minhnhatluongg/lora_project/img/screenshots/13-login-video.png

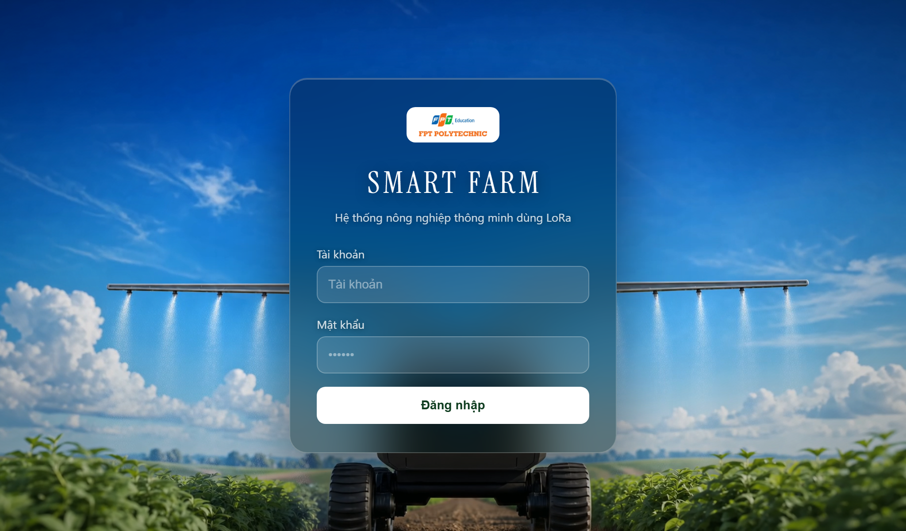
img/screenshots/13-login-video.png
