minhnhatluongg/lora_project/front_require/2.jpg

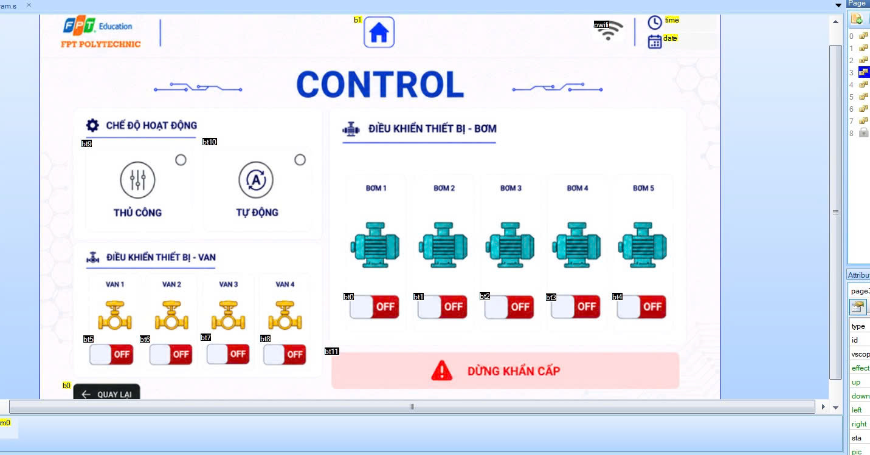
front_require/2.jpg
