minhnhatluongg/lora_project/BAO-CAO-TIEN-DO.docx

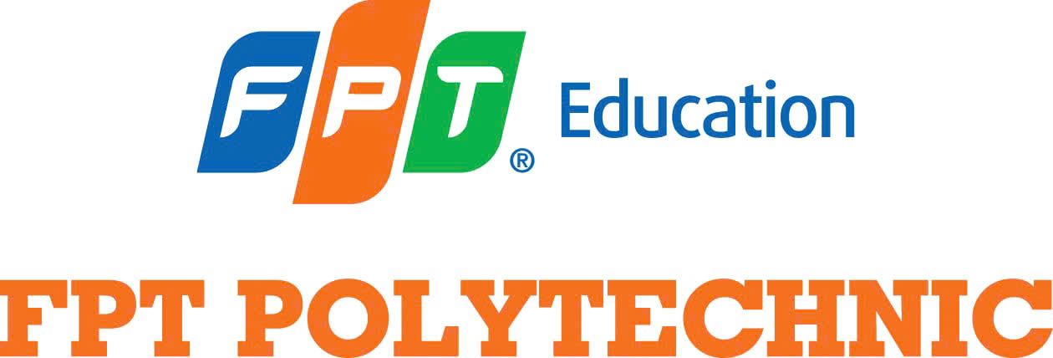
[picture p3: figure]

HỆ THỐNG TƯỚI TIÊU CHÍNH XÁC

ỨNG DỤNG MẠNG LoRa

Báo cáo tiến độ — Luồng điều khiển và kết quả kiểm thử

Kiến trúc ba trạm: STM32F411 · ESP32-S3 · Arduino Nano

Backend Node.js + SQLite · Dashboard React

# 1. Tóm tắt kết quả đợt này

Trọng tâm đợt này là luồng điều khiển (CONTROL) — phần duy nhất còn sai trong khi toàn bộ đường đo và hiển thị số liệu đã chạy đúng. Kết quả gồm ba nhóm: sửa lỗi điều khiển, bổ sung đồng bộ hai chiều, và lần đầu tiên biên dịch kiểm chứng được cả ba board.

## 1.1. Biên dịch kiểm chứng

Trước đợt này chưa từng biên dịch thử; mọi rà soát đều làm bằng mắt. Nay cả ba board đều build sạch:

Board | Bộ nhớ chương trình | RAM | Kết quả
ESP32-S3 | 1.087.601 B (82%) | 48.464 B (14%) | sạch
STM32F411CE | 33.940 B (6%) | 2.148 B (1%) | sạch
Arduino Nano | 12.788 B (41%) | 1.067 B (52%) | sạch

Việc biên dịch phát hiện ba lỗi mà đọc code không thể thấy — trình bày ở mục 4.

# 2. Kiến trúc hệ thống

Ba vi điều khiển, hai chặng LoRa, một cầu WiFi lên máy chủ:

Đầu dò đất RS485 ┐

4 cảm biến siêu âm ├─► STM32F411 ──LoRa──► ESP32-S3 ──WiFi──► Backend :4000

DHT22 + board mưa ┘ (đo, LCD) ▲ (HMI Nextion, └─► Dashboard :5173

│ logic AUTO)

<REQ_DATA> │

ESP32 hỏi thì └──LoRa──► Arduino Nano

STM32 mới trả lời 10 relay

5 bơm · 4 van · 1 đèn báo

Điểm quan trọng về mặt thiết kế: logic tự động nằm trên ESP32, không nằm ở máy chủ. Mất WiFi hay tắt backend thì hệ thống vẫn pha phân và tưới bình thường; chỉ dashboard ngừng cập nhật.

## 2.1. Giao thức giữa các trạm

Bản tin | Chiều | Ý nghĩa
<REQ_DATA> | ESP32 → STM32 | Hỏi số đo. STM32 không tự phát nên không va sóng
<DATA:...> | STM32 → ESP32 | 14 trường: đất, NPK, 4 bồn, không khí, mưa
<ONn> <OFFn> | ESP32 → Nano | Lệnh tay — Nano chỉ nhận khi đang THỦ CÔNG
<AUTOONn> | ESP32 → Nano | Lệnh máy — Nano chỉ nhận khi đang TỰ ĐỘNG
<ACK_> <NACK_> | Nano → ESP32 | Xác nhận hoặc từ chối thật, không ACK giả
<SYNC:> <SYNC_ACK> | hai chiều | Nút cơ mặt tủ, có xác nhận và gửi lại 3 lần
<ESTOP> | ESP32 → Nano | Cắt toàn bộ 10 relay, gửi thẳng không qua hàng đợi

Việc tách lệnh tay và lệnh máy thành hai họ riêng là điểm thiết kế đáng chú ý nhất. Nano áp khóa an toàn đối lập cho hai họ, nên một lệnh tay lọt vào lúc đang chạy tự động sẽ bị từ chối ngay tại board relay — không phụ thuộc phần mềm phía trên có kiểm hay không.

# 3. Luồng điều khiển CONTROL

## 3.1. Ba trạng thái, và vì sao mặc định là "chưa chọn"

Trạng thái | Công tắc bơm/van | Máy tự động
CHƯA CHỌN | khoá toàn bộ | không chạy
THỦ CÔNG | bật/tắt từng cái | không chạy
TỰ ĐỘNG | khoá (phần cứng từ chối) | ESP32 cầm lái

Hệ thống mới cài luôn ở CHƯA CHỌN. Đây là lựa chọn có chủ ý: cả hai chế độ còn lại đều điều khiển bơm thật, nên việc cho máy chạy phải là quyết định có ý thức của người vận hành, không bao giờ là giá trị mặc định. Mô hình này khớp với chính firmware, nơi systemMode khởi tạo bằng -1 nghĩa là "chưa chọn".

## 3.2. Khoá công tắc khi TỰ ĐỘNG là phản ánh sự thật

Web bấm bật Bơm 1

↓

ESP32: systemMode == 1 → từ chối, trả NACK về backend

↓ (giả sử lọt qua)

Nano: isAutoMode == true → "[KHÓA AN TOÀN] từ chối lệnh tay!"

Nếu giao diện vẫn cho bấm thì kết quả là lệnh báo lỗi, không phải thiết bị được bật. Khoá nút là cách nói thật về điều đang xảy ra dưới ruộng, không phải hạn chế do phần mềm tự đặt ra.

## 3.3. Ngưỡng cảnh báo và Luật tự động là hai thứ khác nhau

Đây là chỗ dễ nhầm nhất khi vận hành. Trên màn CÀI ĐẶT có hai mục đều trông giống "ngưỡng":

| Ngưỡng cảnh báo | Luật tự động
Tác dụng | Chỉ hiện cảnh báo | Bật/tắt relay thật
Chạm relay | Không bao giờ | Có
Mặc định | Đang bật | Tắt toàn bộ 9 luật

Phải hội đủ cả ba điều kiện thì relay mới đổi trạng thái: luật được bật và hệ đang ở TỰ ĐỘNG và vừa có gói dữ liệu mới. Thiếu một là không có gì xảy ra — đây là lý do "cài ngưỡng xong mà van không mở".

Khuyến nghị vận hành: để nguyên Luật tự động ở web là tắt. ESP32 có khóa chéo an toàn mà backend hoàn toàn không có.

## 3.4. Khoá chéo an toàn — thứ chỉ ESP32 có

"Khoá chéo" nghĩa là một máy trạng thái bị chặn bởi điều kiện của hệ khác, không chỉ nhìn điều kiện của chính nó. Firmware có bốn lớp:

- Cắt khẩn cấp giữa chừng — bồn nước cạn (trên 80 cm) hoặc mưa to (từ 50%) thì tắt bơm và đóng van ngay giữa chu kỳ tưới, không chờ tưới xong.
- Chưa pha xong thì cấm tưới — máy tưới không khởi động cho tới khi máy pha phân bật cờ isMixingReady. Nước cạn thì không pha được, không pha được thì không tưới được.
- Tuần tự và chờ xác nhận — mở van, chờ 2 giây, rồi mới bật bơm; mất sóng LoRa thì máy trạng thái đứng lại thay vì đi tiếp mù quáng.
- Nano từ chối lệnh tay khi đang tự động — lớp cuối, ngay tại board relay, chặn cả lệnh LoRa lẫn nút cơ trên mặt tủ.

Backend không có lớp nào trong bốn lớp trên: nó không biết bồn cạn, không biết trời mưa, không biết dung dịch đã pha xong chưa. Đó là lý do thực chất của khuyến nghị "chỉ dùng một bộ não".

# 4. Các lỗi đã phát hiện và xử lý

## 4.1. Ba lỗi chỉ lộ ra khi biên dịch thật

Board | Lỗi | Hậu quả nếu để nguyên | Xử lý
Nano | RAM dùng 89%, còn 223 B cho stack | Code dùng String liên tục, heap lớn lên đụng stack, gây reset ngẫu nhiên giữa lúc điều khiển relay | Bọc F() cho 22 chuỗi, còn 52%, dư 981 B
STM32 | Trùng tên biến Serial1 với core | Trình liên kết báo multiple definition, không build được | Đổi tên thành rs485Port
STM32 | Core 3.0.0 đổi HardwareSerial thành lớp trừu tượng | Không build được | Dùng core 2.7.1

## 4.2. Lỗi chặn đường: sai đơn vị EC

Đầu dò RS485 trả về EC theo µS/cm (giá trị cỡ 1500), nhưng ngưỡng trong firmware mặc định 1,0 và 2,0 tức mS/cm, rồi đem so sánh trực tiếp:

if (EC_Value > ecMax) // 1500 > 2.0 → LUÔN ĐÚNG

Hệ quả dây chuyền: máy pha phân kẹt vĩnh viễn ở bước "EC quá cao, châm thêm nước", không bao giờ bật cờ isMixingReady, nên tưới tự động không bao giờ khởi động. Toàn bộ chế độ TỰ ĐỘNG vô hiệu, mà không có thông báo lỗi nào.

Cách sửa giữ nguyên ý định nông học (1,0 và 2,0 mS/cm), chỉ đổi đơn vị cho khớp đầu dò: 1000 và 2000 µS/cm. Thêm hàm quy đổi tại mọi cửa vào để chip đã nạp firmware cũ và người vận hành quen gõ mS/cm đều không bị ảnh hưởng.

Kiểm chứng bằng dải giá trị thật của đầu dò:

EC đo được (µS/cm) | Trước | Sau
400 | pha loãng | châm Đạm + Kali
1200 / 1500 / 1900 | pha loãng | đạt chuẩn
2400 | pha loãng | pha loãng

Trước khi sửa không giá trị nào đạt chuẩn — đúng như suy luận là kẹt vĩnh viễn.

## 4.3. Lỗi "đo đúng mà điều khiển sai"

Triệu chứng người dùng báo: số đo hiển thị chính xác, riêng phần điều khiển sai. Nguyên nhân là hai đường dữ liệu tách biệt — telemetry chạy tốt, còn trạng thái thiết bị thì không.

Mảng pumpState[] mà ESP32 dùng để báo lên dashboard chỉ được cập nhật khi lệnh xuất phát từ web. Ba nguồn còn lại không hề chạm tới nó:

- Bấm nút trên màn Nextion
- Bấm nút cơ dưới tủ điện
- Máy trạng thái AUTO và pha phân tự bật relay — nguồn quan trọng nhất

Kết quả mô phỏng lại đúng bốn đường điều khiển:

| Bơm 1 | Bơm 2 | Bơm 3 | Bơm 4 | Bơm 5 | Van 1
Thực tế dưới ruộng | ON | ON | ON | OFF | ON | ON
Web thấy — trước | ON | ON | ON | ON | OFF | OFF
Web thấy — sau | ON | ON | ON | OFF | ON | ON

Hai kiểu sai cùng lúc: Bơm 4 web báo đang chạy dù Nano đã từ chối lệnh, tức là chưa hề chạy; còn Bơm 5 và Van 1 do máy tự động bật thì web lại báo tắt.

Cách sửa theo nguyên tắc chỉ ghi trạng thái khi Nano đã xác nhận bằng ACK, thay vì ghi lạc quan lúc bấm nút. Một chỗ ghi duy nhất, phủ đủ bốn đường; lệnh bị NACK thì trạng thái giữ nguyên và nút trên màn được kéo về đúng thực tế.

## 4.4. Vùng chết khi bấm nút

Khối xử lý nút bơm/van chỉ có điều kiện systemMode == 0 && !isWaitingAck mà không có nhánh nào khác. Ba tình huống rất hay gặp rơi vào khoảng trống và im lặng tuyệt đối: chưa chọn chế độ, đang ở tự động, và đang chờ xác nhận lệnh trước (cửa sổ tới 6 giây). Người vận hành bấm nút, relay không kêu, màn không báo gì — mà nút thì đã tự đổi màu lúc chạm vào.

Nay mỗi nhánh đều kết thúc bằng một việc thấy được: thông báo trên OLED và đẩy nút về đúng trạng thái thật.

# 5. Nâng cấp luồng điều khiển

## 5.1. Đồng bộ chế độ hai chiều

Chế độ đổi được ở ba nơi: dashboard, màn Nextion, và nút cơ trong tủ điện. Trước đây chỉ nơi đầu tiên đi qua máy chủ, nên web có thể ngồi hiện THỦ CÔNG trong khi ngoài ruộng đã chạy TỰ ĐỘNG cả tiếng.

Bổ sung endpoint POST /api/status/report xác thực bằng khoá thiết bị; ESP32 báo về ở cả ba nguồn. Mỗi lần đổi còn ghi một dòng vào nhật ký cảnh báo, để đọc lại biết vì sao hệ thống bắt đầu hoặc ngừng tưới.

## 5.2. Nút TỰ ĐỘNG nay giao quyền, không bật sẵn thiết bị

Bản trước, bấm TỰ ĐỘNG thì web bật sẵn cả 9 thiết bị rồi mới giao quyền. Bỏ cách làm đó vì hai lẽ: máy trạng thái trên ESP32 ghi đè lại sau vài giây, và bật bơm Đạm/Kali khi chưa pha, chưa khuấy là sai quy trình dinh dưỡng.

Việc quét bật lần lượt toàn dàn được tách thành nút riêng "Kiểm tra toàn dàn", chỉ hiện ở chế độ THỦ CÔNG — đúng lúc nó có ích: nghiệm thu đấu dây tủ điện. Quét giữ hai ràng buộc kỹ thuật: van mở trước bơm (bơm chạy vào ống đóng là chạy chết máy) và cách nhau 2 giây (năm mô-tơ đóng cùng lúc là cú dòng khởi động lớn lên nguồn chung).

## 5.3. Dải tiến trình máy trạng thái

Ở chế độ TỰ ĐỘNG, màn CONTROL trước đây chỉ còn chữ "TỰ ĐỘNG" và chín công tắc xám. Người đứng xem không có cách nào biết hệ thống đang làm gì — mà "vì sao chưa tưới" gần như luôn là câu hỏi đầu tiên.

ESP32 nay gửi kèm bước hiện tại của hai máy trạng thái, dashboard vẽ thành dải tiến trình:

Pha phân: [đổ nước] → [đo EC] → [châm Đạm+Kali] → [khuấy] → đạt chuẩn

│

chưa đạt chuẩn thì KHÓA tưới

↓

Tưới: [chờ đất khô] → [mở van] → [đang tưới] → [đóng van] → [nghỉ thấm]

Dải này vẽ đúng quan hệ nối tiếp giữa hai máy: pha phân phải xong thì tưới mới được phép khởi động. Nhờ vậy màn hình trả lời được câu hỏi vận hành thường gặp nhất — hệ thống đang chờ gì — thay vì chỉ cho biết nó đang bật hay tắt.

# 6. Kiểm thử đã thực hiện

Hạng mục | Cách kiểm | Kết quả
Biên dịch 3 board | Trình biên dịch thật của Arduino | sạch cả ba
Giao thức 3 trạm | Đối chiếu 7 hợp đồng bản tin hai chiều | khớp toàn bộ
Đơn vị EC | Chạy lại quyết định pha phân với dải EC thật | trước kẹt, sau đạt chuẩn
Trạng thái thiết bị | Mô phỏng 4 đường điều khiển kèm trường hợp bị từ chối | dashboard khớp thực tế
Đồng bộ chế độ | Máy chủ chạy thật, giả lập ESP32 báo về | web nhận đúng
Kiểm tra toàn dàn | Đọc thẳng hàng đợi lệnh trong cơ sở dữ liệu | van trước bơm, cách 2 giây
Phân quyền | Gọi API không kèm khoá thiết bị | trả về 401

# 7. Việc còn lại

Việc | Ghi chú
Nạp và chạy thử trên phần cứng thật | Toàn bộ kiểm thử hiện ở mức biên dịch và mô phỏng logic
Sửa nhãn đơn vị EC trên màn Nextion | Đổi mS/cm thành µS/cm, và nới `txt_maxl` lên ít nhất 8 vì số hiển thị dài từ 3 lên 6 ký tự
Chốt giá trị EC theo cây trồng | Hiện đặt 1000–2000 µS/cm, đúng bằng ý định ban đầu của nhóm
Đấu relay cho bơm 2 đến 5 | Phần mềm đã hỗ trợ đủ 5 bơm
