minhnhatluongg/lora_project/HUONG-DAN-TRIEN-KHAI.docx

HỆ THỐNG TƯỚI CHÍNH XÁC LORAWAN

HƯỚNG DẪN TRIỂN KHAI & CẤU HÌNH KHI CHẠY THẬT

“Ứng dụng công nghệ LoRaWAN trong thiết kế hệ thống tưới chính xác

và quản lý dinh dưỡng cho cây ăn quả”

Tài liệu này dùng để làm gì

Trả lời đúng một câu hỏi: cần sửa biến nào, trên máy nào, để tải nguồn về là hệ thống chạy được.

Phần 3 là bảng tra cứu chính. Các phần còn lại là các bước làm và cách xử lý khi hỏng.

# 1. Toàn cảnh hệ thống

Hệ thống gồm 5 thành phần. Ba board phần cứng chạy độc lập với nhau, và một cặp phần mềm chạy trên máy tính.

Đầu dò đất RS485 ─┐

4 × siêu âm ──────┼─► STM32F411 ──LoRa E32 (2 phút/lần)──┐

Không khí + mưa ──┘ │

▼

Nextion HMI ◄──UART── ESP32-S3 MASTER ──WiFi/HTTP──► BACKEND :4000

│ │

│ LoRa E32 ▼

▼ DASHBOARD :5173

Arduino Nano ──► 10 relay

(5 bơm · 4 van · 1 báo AUTO)

Thành phần | Vai trò | Chạy ở đâu
STM32F411 | Đọc cảm biến, hiện LCD, phát LoRa mỗi 2 phút | Tủ ngoài vườn
ESP32-S3 | Master: HMI Nextion, logic AUTO, cầu nối lên web | Tủ điều khiển
Arduino Nano | Đóng cắt 10 relay, nhận nút cơ dưới tủ | Tủ điện
Backend | API + cơ sở dữ liệu SQLite | Máy tính
Dashboard | Giao diện web 5 trang | Trình duyệt

Mất mạng thì sao?

Hệ thống vẫn tưới bình thường. ESP32 có logic AUTO chạy tại chỗ, Nextion và nút cơ dưới tủ vẫn dùng được.

Chỉ có dashboard web là không cập nhật cho tới khi mạng trở lại.

# 2. Chuẩn bị trước khi bắt đầu

Trên máy tính:

- Node.js phiên bản 18 trở lên — kiểm tra bằng node -v
- Arduino IDE, đã cài board ESP32 và 2 thư viện Adafruit GFX + Adafruit SSD1306
- PlatformIO (extension trong VS Code) để nạp STM32

Về mạng:

- Máy chạy backend và ESP32 phải cùng một mạng WiFi
- Ghi lại địa chỉ IP của máy chạy backend — lấy bằng lệnh ipconfig, xem dòng *IPv4 Address*, ví dụ 192.168.1.50
- Mở cổng 4000 trên tường lửa Windows (lệnh ở phần 4)

IP là thứ hay gây lỗi nhất

IP do router cấp có thể đổi sau khi khởi động lại. Nếu hôm nay chạy được mà mai không, hãy kiểm tra IP trước tiên.

Cách chắc chắn: vào router đặt IP tĩnh (DHCP reservation) cho máy chạy backend.

# 3. Bảng biến cấu hình theo từng máy

Đây là phần quan trọng nhất. Cột “Khi nào phải sửa” cho biết biến đó có bắt buộc động vào hay không.

## 3.1 Máy tính chạy backend — file backend/.env

Lần đầu: chép backend/.env.example thành backend/.env rồi sửa file .env.

Biến | Giá trị mặc định | Khi nào phải sửa
PORT | 4000 | Chỉ khi cổng 4000 đã bị chương trình khác chiếm. Sửa thì phải sửa cả ESP32 và vite.config.js.
DEVICE_API_KEY | changeme-esp32-secret | Đã khớp sẵn với ESP32 → KHÔNG cần sửa. Nếu đổi thì phải đổi cả hai phía.
JWT_SECRET | changeme-jwt-secret | Nên đổi thành chuỗi ngẫu nhiên dài trước khi dùng thật.
SEED_ADMIN_PASSWORD | admin123 | Chỉ có tác dụng lần chạy ĐẦU TIÊN khi database còn trống. Đã chạy rồi thì đổi trong giao diện web.
CORS_ORIGIN | http://localhost:5173 | Chỉ khi mở dashboard từ MÁY KHÁC. Xem mục 3.3.
TELEMETRY_RETENTION_DAYS | 90 | Số ngày giữ dữ liệu đo. Đặt 0 để giữ mãi mãi.
MASTER_TIMEOUT_SECONDS | 30 | Bao lâu không có tin thì báo Master OFFLINE. Thường không cần sửa.

## 3.2 ESP32-S3 — file firmware/esp32_master/esp32_master.ino

Khối cấu hình nằm ngay đầu file, có khung dấu # bao quanh cho dễ tìm.

Biến | Giá trị mặc định | Khi nào phải sửa
ssid | "DESKTOP-2GO7JB8 5238" | BẮT BUỘC — tên WiFi của bạn.
password | "78U5%g77kkkkk" | BẮT BUỘC — mật khẩu WiFi.
BACKEND_BASE | "http://192.168.1.50:4000" | BẮT BUỘC — đổi thành IP thật của máy chạy backend. Không dùng localhost.
DEVICE_API_KEY | "changeme-esp32-secret" | Đã khớp sẵn với backend → KHÔNG cần sửa.
ENABLE_WEB_BRIDGE | 1 | Đặt 0 nếu muốn chạy hoàn toàn offline, chỉ dùng Nextion.
CMD_POLL_INTERVAL | 3000 | Bao lâu hỏi lệnh mới từ web (mili giây). Thường không cần sửa.

Vì sao không được dùng localhost trên ESP32

Với ESP32, localhost nghĩa là chính con ESP32, không phải máy tính của bạn. Bắt buộc phải điền IP LAN dạng 192.168.x.x.

## 3.3 Dashboard — khi backend và trình duyệt KHÔNG cùng máy

Đây là chỗ dễ vấp nhất khi nhiều người cùng dùng. Có ba tình huống:

Tình huống | Cần làm gì
Backend + dashboard + trình duyệt cùng 1 máy (cách dùng thông thường) | Không sửa gì cả. Mở http://localhost:5173
Backend + dashboard cùng 1 máy, xem từ điện thoại / máy khác | Không sửa code. Chạy npm run preview (đã bật sẵn --host) rồi vào http://<IP-máy-đó>:5173. Proxy chạy trên máy chủ nên vẫn trỏ đúng, không cần đụng CORS.
Backend ở MÁY A, dashboard chạy ở MÁY B | Sửa frontend/vite.config.js: đổi cả hai dòng http://localhost:4000 thành http://<IP-máy-A>:4000. Sau đó thêm origin của máy B vào CORS_ORIGIN trong backend/.env.

## 3.4 STM32 — file firmware/stm32_sensor_node/src/main.cpp

Biến / Hàm | Mặc định | Khi nào phải sửa
LORA_SEND_INTERVAL | 120000 (2 phút) | Muốn dashboard cập nhật dày hơn thì giảm. Đổi lại tốn pin và chiếm sóng.
readAirSensors() | đang gán số giả | BẮT BUỘC nếu đã lắp cảm biến thật — xem mục 6.
Dist4 = rawD4 + 13.0 | bù 13 cm | Giá trị bù theo sa bàn cũ. Đo lại thực tế rồi chỉnh cho đúng bồn của bạn.

## 3.5 Arduino Nano — file firmware/nano_relay/nano_relay.ino

Bình thường không cần sửa gì. Chỉ đụng vào relayPins[] nếu bạn đấu relay vào chân khác.

Thiết bị trên web | Lệnh LoRa | Chân Nano
pump1 … pump5 (Bơm 1–5) | <ON1> … <ON5> | A1, A0, D2, D3, D4
van1 … van4 (Van 1–4) | <ON6> … <ON9> | D5, D6, D7, D8
(đèn báo đang ở AUTO) | — | D9

# 4. Các bước chạy, theo đúng thứ tự

Làm tuần tự. Mỗi bước có mốc nghiệm thu — chưa đạt thì đừng sang bước sau, vì càng về sau càng khó biết hỏng ở đâu.

## Bước 1 — Chạy backend

cd backend

npm install

copy .env.example .env (Linux/macOS: cp .env.example .env)

npm run seed (tùy chọn: nạp dữ liệu mẫu cho biểu đồ)

npm start

Nghiệm thu: mở http://localhost:4000/api/health phải thấy {"ok":true,...}

## Bước 2 — Chạy dashboard

cd frontend

npm install

npm run build

npm run preview

Nghiệm thu: mở http://localhost:5173, đăng nhập admin / admin123, thấy trang MENU với 6 ô.

## Bước 3 — Mở cổng tường lửa

Chạy PowerShell với quyền Administrator:

New-NetFirewallRule -DisplayName "LoRa backend 4000" -Direction Inbound -LocalPort 4000 -Protocol TCP -Action Allow

## Bước 4 — Nạp Arduino Nano

Mở firmware/nano_relay/nano_relay.ino, nạp. Không cần sửa gì.

Nghiệm thu: Serial Monitor 9600 baud hiện “NANO 2 (SLAVE): SAN SANG NHAN LORA”.

## Bước 5 — Nạp STM32

cd firmware/stm32_sensor_node

pio run (biên dịch thử TRƯỚC khi nạp)

pio run -t upload

pio device monitor

Nghiệm thu: Serial in số đo mỗi giây, LCD hiện dữ liệu, bấm PB5 đổi được 3 trang.

## Bước 6 — Nạp ESP32 (bước quyết định)

Sửa 3 dòng ở mục 3.2 rồi nạp firmware/esp32_master/esp32_master.ino.

Nghiệm thu: Serial Monitor 115200 phải hiện lặp lại:

WiFi connected: 192.168.x.x

[WEB] POST /telemetry -> 201

Mã hiện ra | Nghĩa là gì | Xử lý
201 | Đã ghi dữ liệu thành công | Không phải làm gì
401 | Sai khóa API | So lại DEVICE_API_KEY giữa sketch và backend/.env
-1 | Không nối được tới backend | Sai IP, khác mạng WiFi, hoặc tường lửa chặn
không in gì | Chưa nhận được gói LoRa từ STM32 | Kiểm tra nguồn và ăng-ten module E32 hai đầu

## Bước 7 — Hiệu chuẩn 4 bồn nước

Bắt buộc, nếu bỏ qua thì phần trăm mực nước sẽ sai.

Cảm biến đo khoảng cách từ đầu dò xuống mặt nước — nước càng đầy thì số càng nhỏ.

- Vào SETTINGS → Hiệu chuẩn bồn nước, với mỗi bồn điền 2 số: khoảng cách khi bồn cạn và khi bồn đầy.
- Cột “Đọc hiện tại” hiện ngay kết quả quy đổi để đối chiếu. Nếu bồn đang đầy mà báo 8% thì bạn đã điền ngược hai ô.
- Đổi hiệu chuẩn lúc nào cũng được — phần trăm tính lúc đọc nên dữ liệu lịch sử cũng tự sửa theo.

# 5. Nghiệm thu toàn tuyến

Trên trang DASHBOARD, các thẻ trạng thái phải đúng như sau:

Chỗ cần nhìn | Đúng là thế nào
Thẻ Master | ONLINE — ESP32 có gọi backend trong 30 giây qua
Thẻ Slave | ONLINE — có gói LoRa từ STM32
Thẻ RS485 | “Đọc tốt”
4 thẻ hàng trên | Nhiệt độ, Độ ẩm, pH, EC có số và đổi theo thời gian
Thẻ Kali & Đạm | Có 2 số, đơn vị ppm
3 thẻ không khí / mưa | Có số (nếu đã lắp cảm biến thật — xem mục 6)
Mực nước các bồn | Đúng % so với bồn thật sau khi hiệu chuẩn
Trang CONTROL | Bật/tắt được bơm và van khi ở chế độ THỦ CÔNG

Kiểm tra nút DỪNG KHẨN CẤP (nên làm ít nhất một lần):

- Vào trang CONTROL, bấm DỪNG KHẨN CẤP và xác nhận.
- Toàn bộ 10 relay phải nhả ra, hệ thống tự chuyển về THỦ CÔNG.
- Thử bật một bơm — phải bị từ chối cho tới khi giải trừ.

# 6. Những phần phần cứng chưa hoàn thiện

Phần mềm đã sẵn sàng nhận, nhưng phần cứng còn thiếu. Không ảnh hưởng tới các chức năng khác.

Trên màn hình | Còn thiếu gì
Độ ẩm không khí Nhiệt độ không khí Cảm biến mưa | Hàm readAirSensors() trong main.cpp đang gán số cứng: AirTemp = 32.5; AirHum = 70.0; RainPercent = 15; Thay bằng lệnh đọc DHT22/SHT31 và board cảm biến mưa thật.
Bơm 2 … Bơm 5 | Cần đấu đủ relay và kiểm tra chân trên Nano. Web và LoRa đã điều khiển được sẵn.

## 6b. Ánh xạ 4 bồn — đã chốt theo dây thật

Nhóm phần cứng đã xác nhận thứ tự này. Backend và dashboard đã đặt tên theo đúng đây.

Cảm biến | Chân STM32 | Biến | Bồn
Siêu âm 1 | PB13 (ECHO1) | Dist1 | Bồn Đạm
Siêu âm 2 | PB14 (ECHO2) | Dist2 | Bồn Kali
Siêu âm 3 | PB15 (ECHO3) | Dist3 | Bồn Nước
Siêu âm 4 | PA8 (ECHO4) | Dist4 | Bồn Trộn

Dời đầu dò sang chân khác thì chỉ cần đổi tên trong SETTINGS → Hiệu chuẩn bồn nước, không phải sửa code.

Hệ quả: logic AUTO trong ESP32 đang dùng nhầm hai biến

Với ánh xạ đã chốt ở trên, hai chỗ trong esp32_master.ino tham chiếu ngược nhau:

• if (Dist3 > 50.0) — định đọc mức bồn Trộn để bơm nước vào, nhưng Dist3 là bồn Nước

• isTankEmpty = (Dist4 > 80) — định đọc mức bồn Nước cho khóa an toàn, nhưng Dist4 là bồn Trộn

Hậu quả: bơm châm nước vào bồn trộn chạy theo mực bồn nguồn, và khóa an toàn “hết nước” kích hoạt theo mực bồn trộn.

Cách sửa: đổi chỗ hai biến trong handleAutoMixingLogic() và handleAutoIrrigationLogic() — dùng Dist4 cho bồn trộn, Dist3 cho bồn nước.

Chưa tự sửa vì đây là logic điều khiển bơm thật. Chạy ở chế độ THỦ CÔNG thì không ảnh hưởng gì.

# 7. Lỗi thường gặp

Hiện tượng | Nguyên nhân thường gặp
Dashboard trống, Master OFFLINE | ESP32 chưa nối được WiFi, hoặc sai IP backend, hoặc tường lửa chặn cổng 4000.
Serial ESP32 in -> 401 | DEVICE_API_KEY trong sketch khác trong backend/.env.
Bấm nút trên web không có gì xảy ra | Hệ thống đang ở TỰ ĐỘNG. Nano khóa mọi lệnh tay. Chuyển sang THỦ CÔNG.
Web hiện bơm ON nhưng thực tế không chạy | Xem trang Cảnh báo. Nếu có “lệnh không được xác nhận” thì đường LoRa xuống Nano đang đứt.
Thẻ RS485 báo “Không phản hồi” | Nguồn đầu dò (thường 12V), thử đảo 2 dây A/B, kiểm tra địa chỉ Modbus phải là 0x02.
Thẻ RS485 báo “Sai CRC” | Nhiễu: gắn điện trở 120Ω hai đầu bus, dùng dây đôi xoắn, tách xa dây động lực bơm.
Một bồn báo “Mất tín hiệu” | Mặt nước xa quá 4m, cảm biến lắp nghiêng, hoặc 4 cảm biến nhiễu chéo nhau (dùng chung chân Trig).
Số liệu 2 phút mới đổi một lần | Đúng như thiết kế. Bấm nút PB7 trên STM32 để ép gửi ngay.
Hôm qua chạy, hôm nay không | Kiểm tra IP máy backend trước tiên — router có thể đã cấp IP khác.

Về bảo mật

Khóa changeme-esp32-secret nằm công khai trong mã nguồn. Chấp nhận được với mạng LAN nội bộ phòng lab.

Đổi cả hai phía (backend/.env và sketch ESP32) nếu hệ thống được mở ra Internet, và đổi luôn JWT_SECRET cùng mật khẩu admin.

Nút DỪNG KHẨN CẤP trên web là chốt chặn phần mềm. Nó không thay thế nút dừng khẩn cấp cứng nối trực tiếp vào nguồn relay — hệ bơm nước ngoài đồng vẫn nên có một nút cơ khí độc lập.

Chi tiết kỹ thuật xem thêm: README.md, HUONG-DAN-CHAY-THAT.md và firmware/README.md trong mã nguồn.
