minhnhatluongg/lora_project/front_require/1.jpg

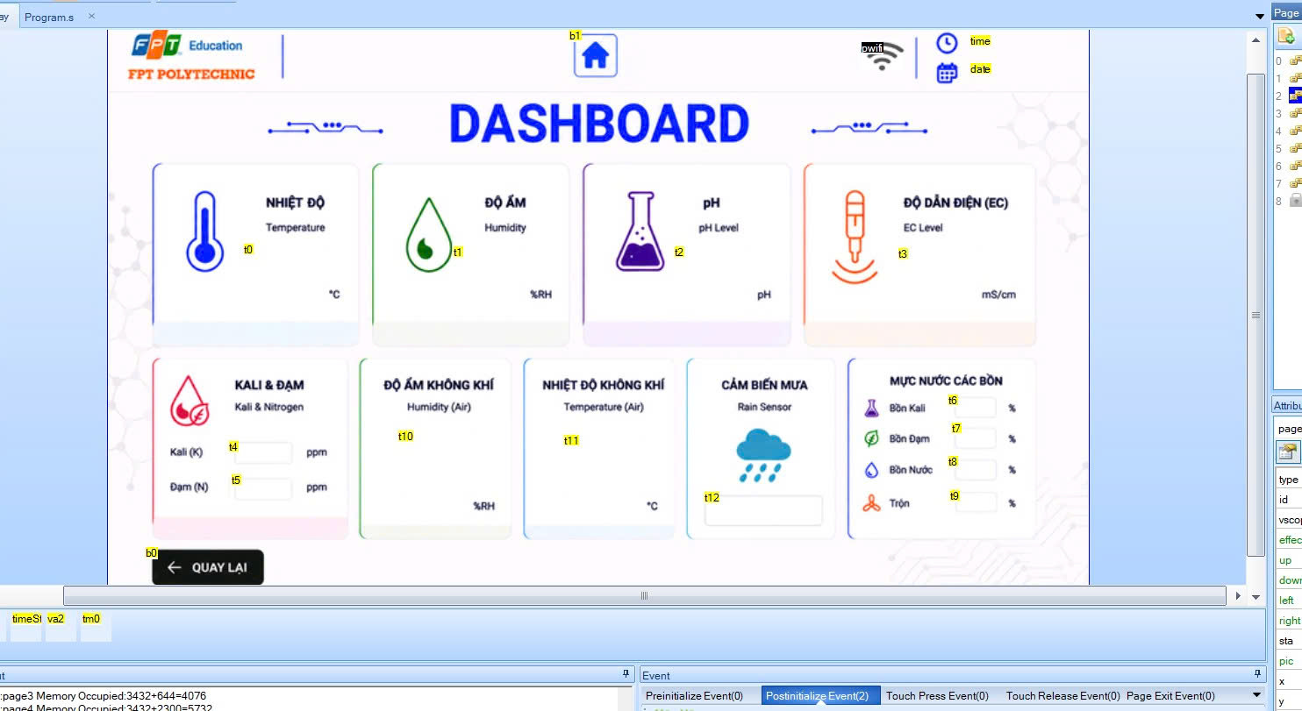
front_require/1.jpg
