minhnhatluongg/lora_project/front_require/3.jpg

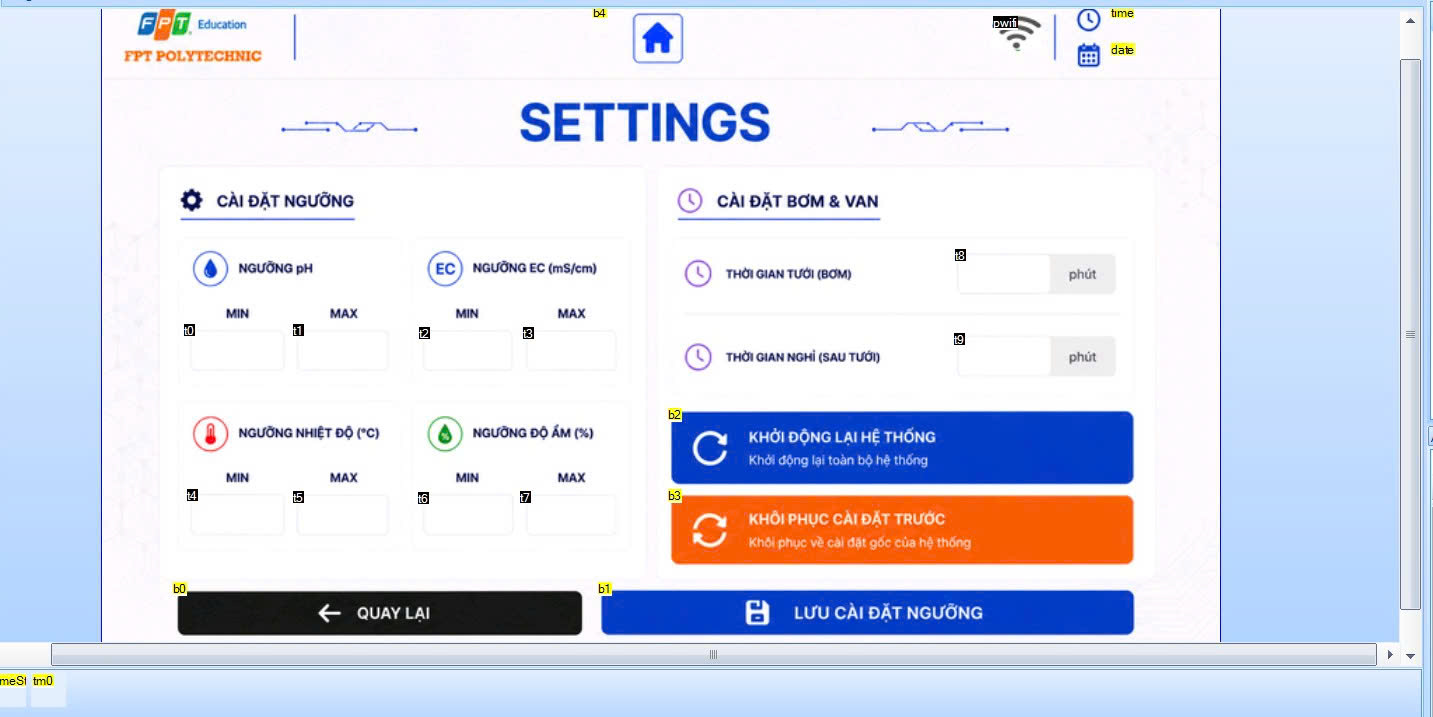
front_require/3.jpg
