minhnhatluongg/lora_project/front_require/4.jpg

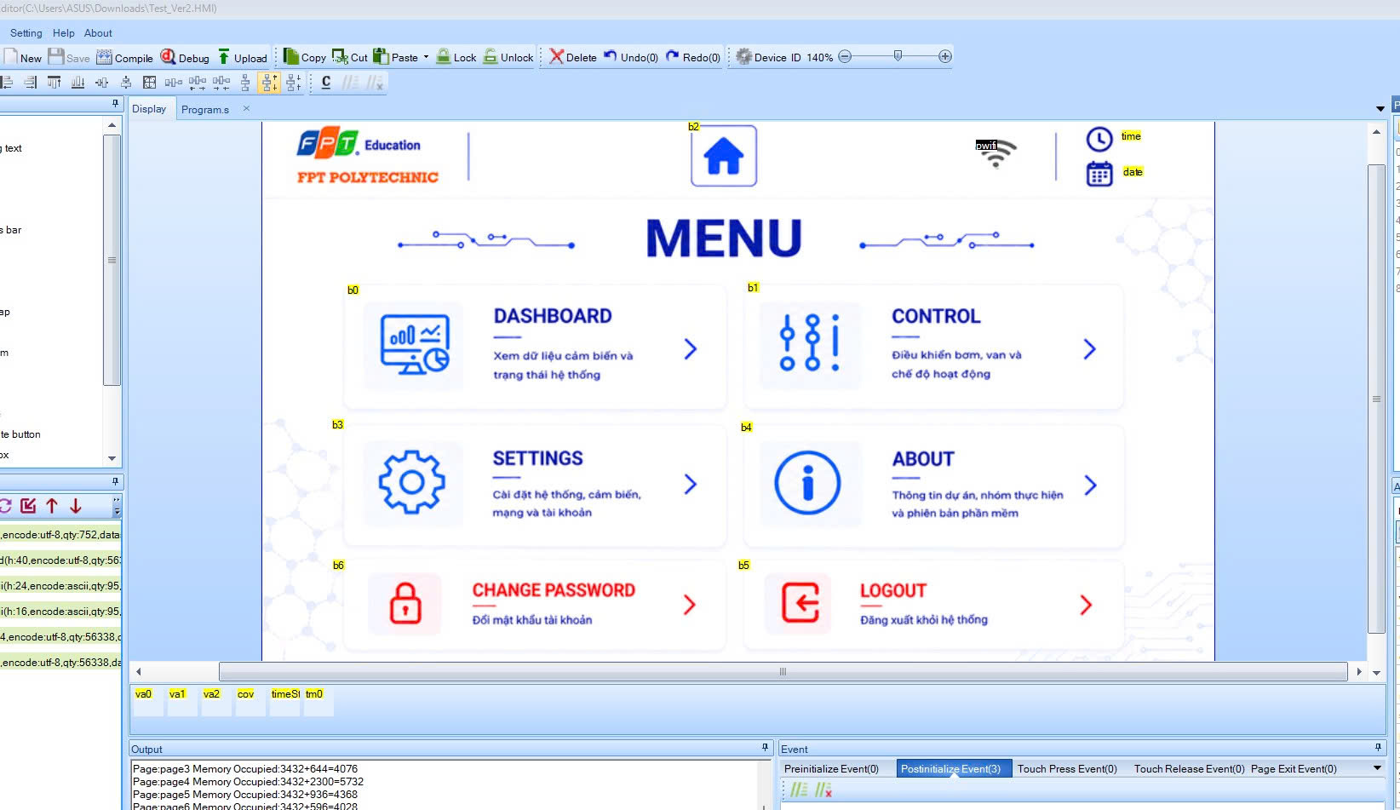
front_require/4.jpg
