minhnhatluongg/lora_project/front_require/5.jpg

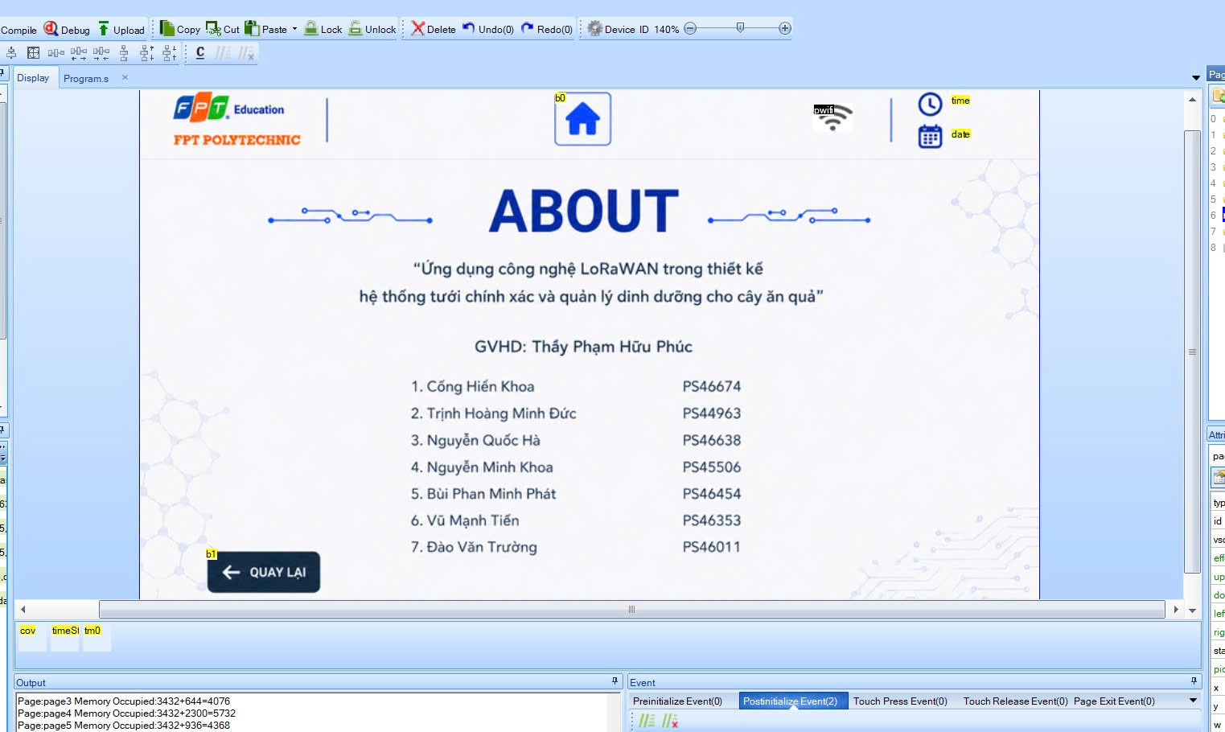
front_require/5.jpg
