minhnhatluongg/lora_project/img/screenshots/01-menu.png

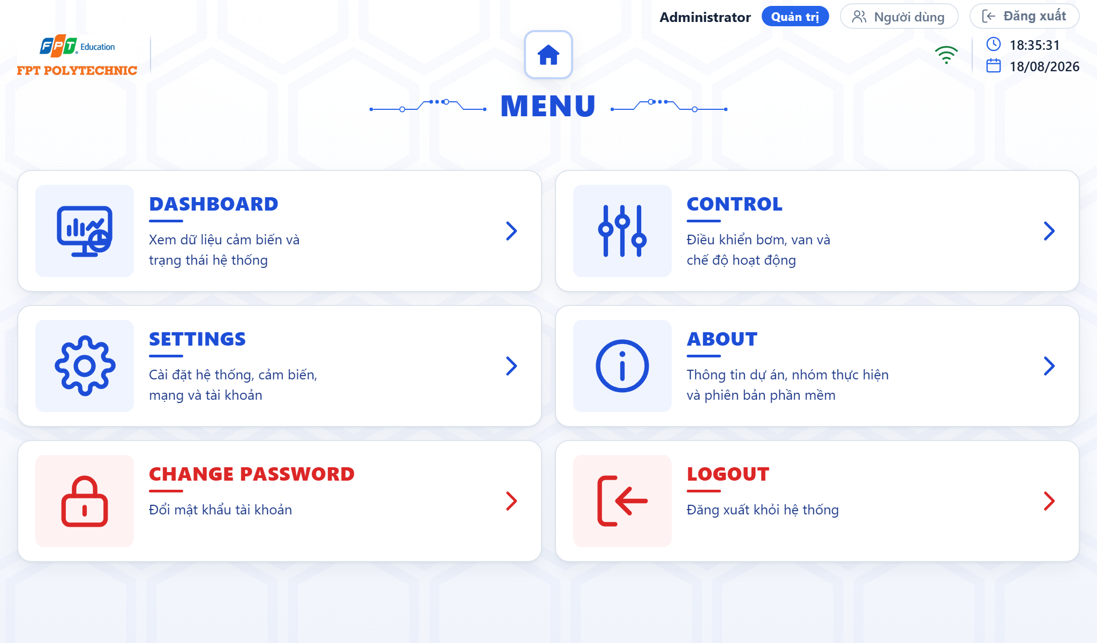
img/screenshots/01-menu.png
