minhnhatluongg/lora_project/img/screenshots/02-control-thu-cong.png

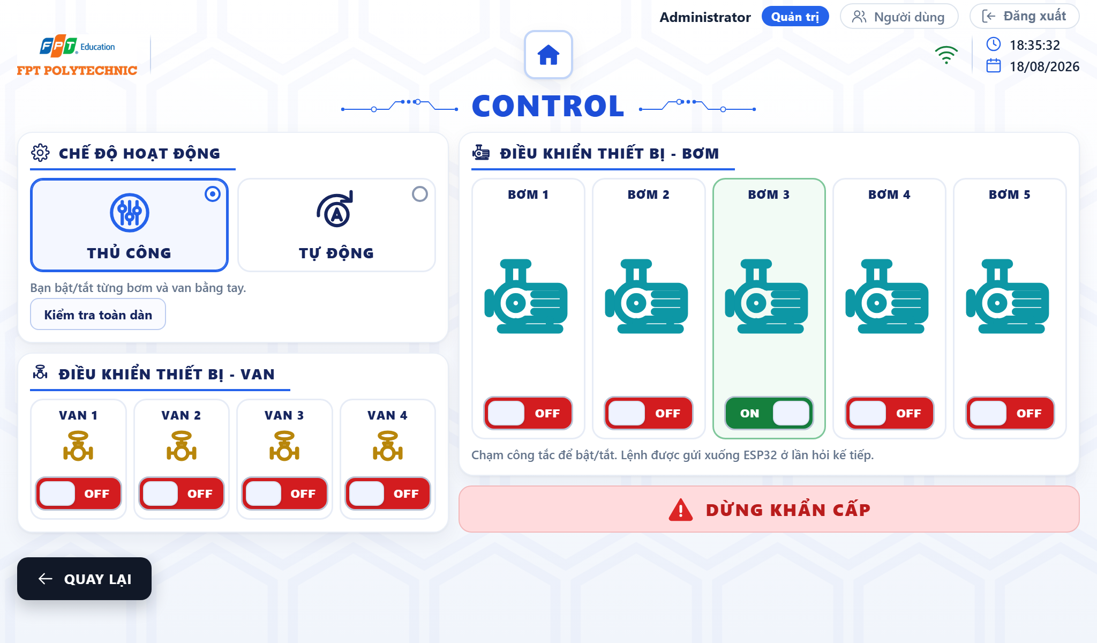
img/screenshots/02-control-thu-cong.png
