minhnhatluongg/lora_project/img/screenshots/03-settings-toggle.png

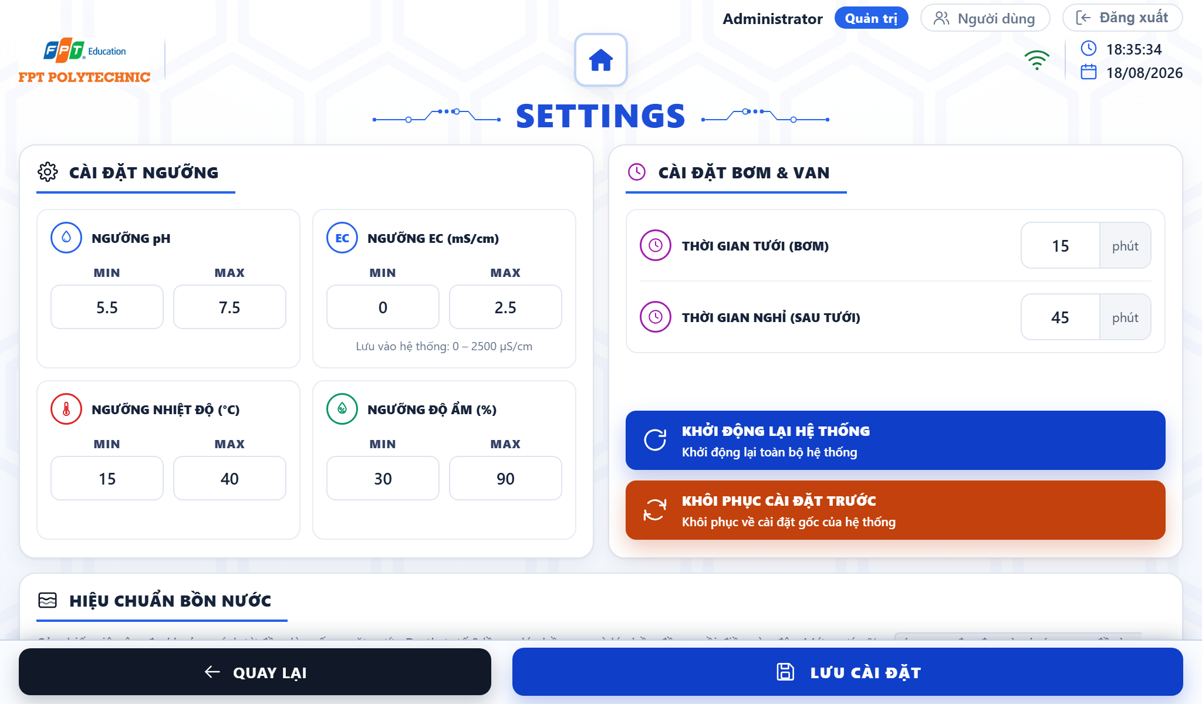
img/screenshots/03-settings-toggle.png
