minhnhatluongg/lora_project/img/screenshots/04-settings-toggle-luat.png

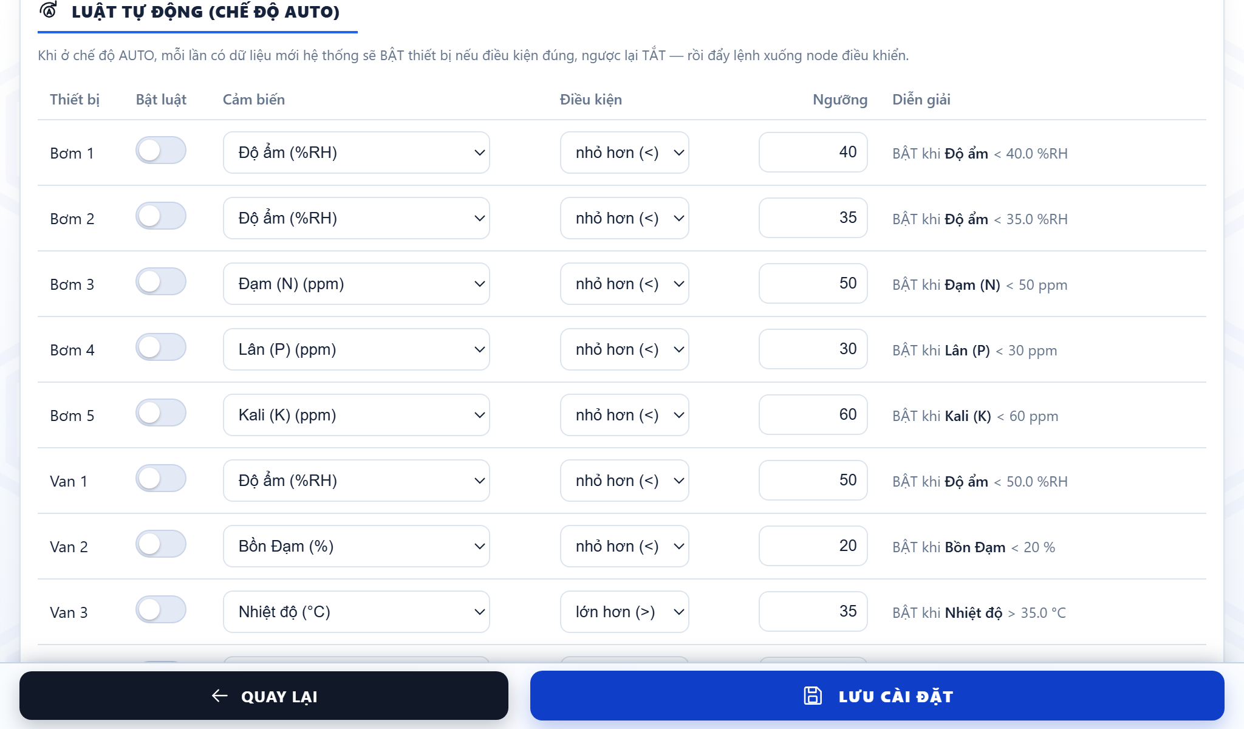
img/screenshots/04-settings-toggle-luat.png
