minhnhatluongg/lora_project/img/screenshots/05-control-quet-dang-chay.png

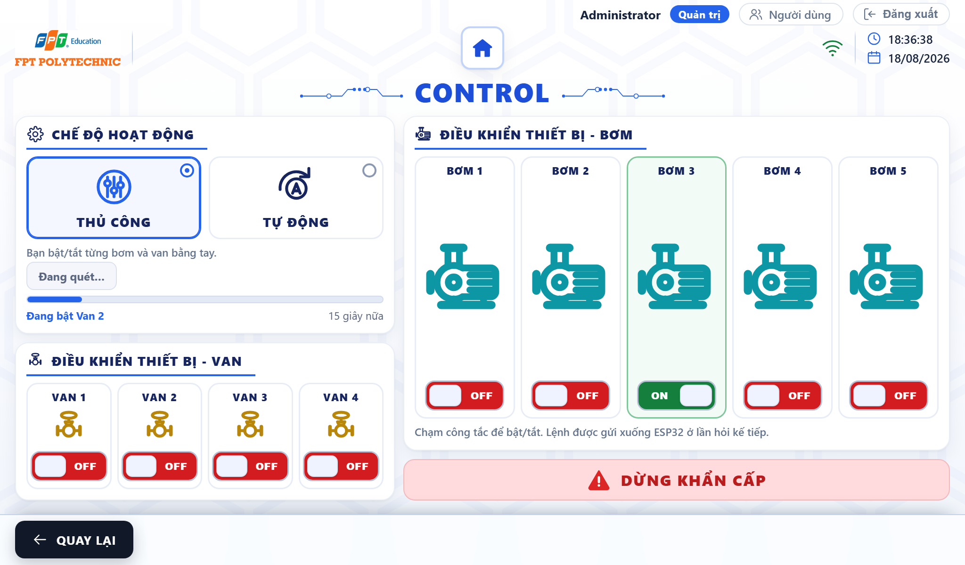
img/screenshots/05-control-quet-dang-chay.png
