minhnhatluongg/lora_project/img/screenshots/07-control-quet-xong.png

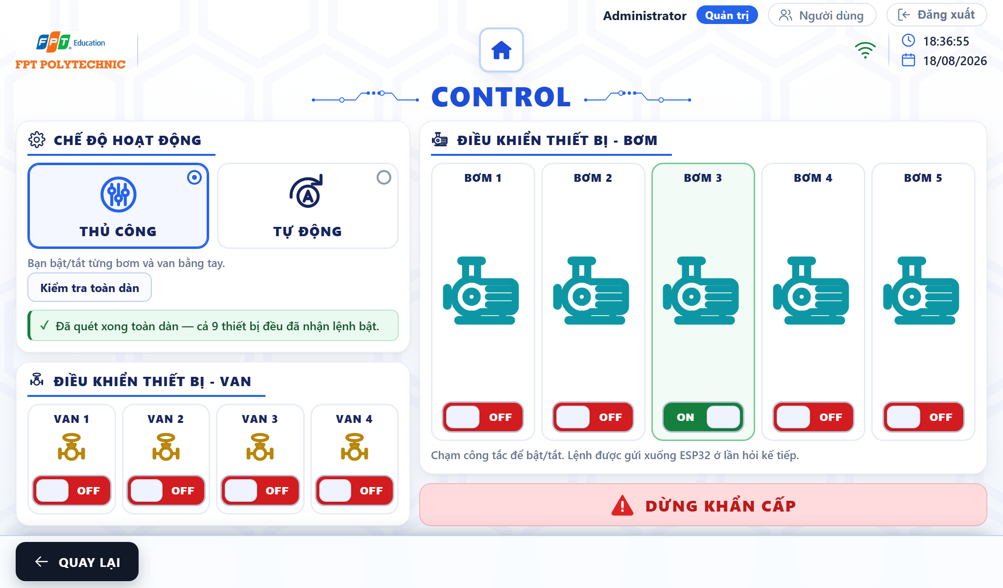
img/screenshots/07-control-quet-xong.png
