minhnhatluongg/lora_project/img/screenshots/08-control-tu-dong-dang-pha.png

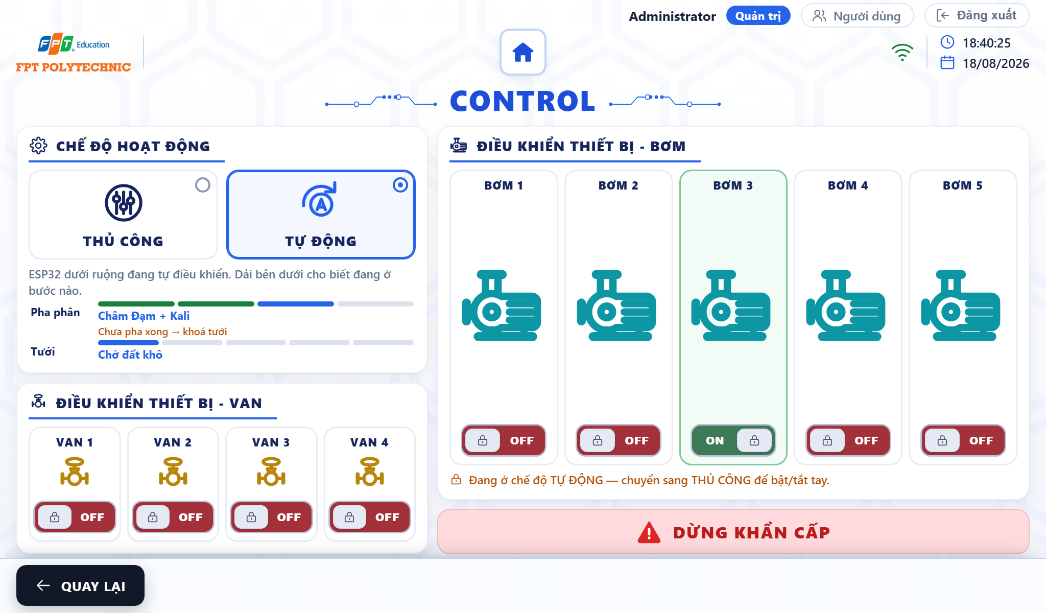
img/screenshots/08-control-tu-dong-dang-pha.png
