minhnhatluongg/lora_project/img/screenshots/09-control-tu-dong-dang-tuoi.png

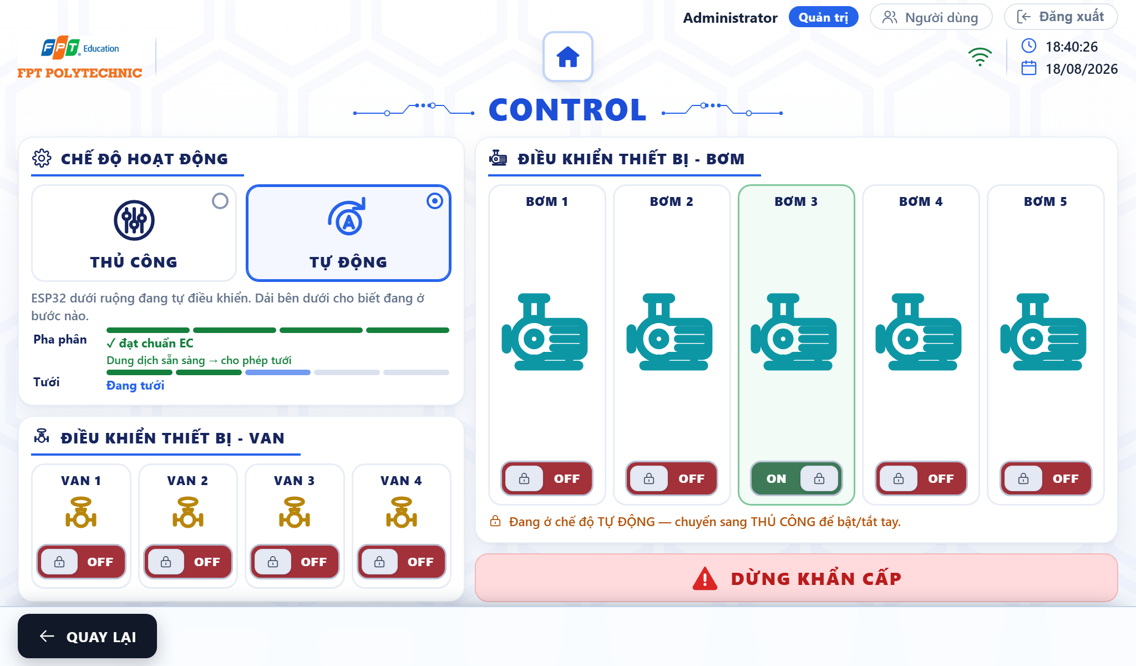
img/screenshots/09-control-tu-dong-dang-tuoi.png
