minhnhatluongg/lora_project/img/screenshots/10-dashboard-nut-lay-du-lieu.png

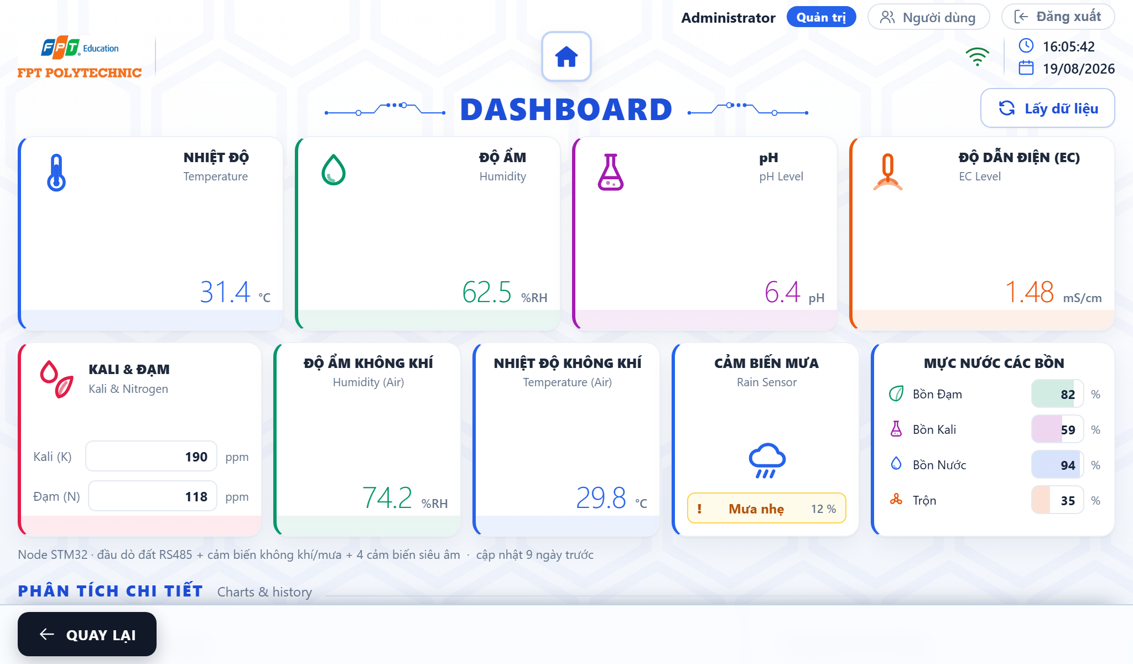
img/screenshots/10-dashboard-nut-lay-du-lieu.png
