minhnhatluongg/lora_project/Bug_Log_Smart_Farm.xlsx

Mã lỗi | Phân hệ (Module) | Mô tả hiện tượng (Bug Description) | Nguyên nhân kỹ thuật (Root Cause) | Trạng thái & Hướng xử lý (Action Plan)
BUG-01 | Đồng bộ Cấu hình (HMI -> Web) | Đổi thông số ngưỡng trên màn hình HMI, ấn Lưu nhưng giao diện Web không hiển thị số mới. | ĐÚNG (đã kiểm chứng). Chính xác hơn: sự kiện này chưa hề tồn tại ở CẢ HAI phía, không phải Frontend thiếu lắng nghe. Backend setConfig() chỉ ghi SQLite rồi return, và danh sách EVENTS trong realtime.js không có mục nào cho cấu hình — nên không có gì để Frontend nghe. | ĐÃ SỬA. Thêm sự kiện 'config-changed'; setConfig() phát chuông ở mọi đường ghi, kể cả POST /api/config/thresholds do ESP32 gửi lên từ màn hình HMI. Chuông đi RỖNG (không kèm nội dung) vì socket chưa xác thực — client nghe được thì tự gọi lại GET /api/config bằng token của mình. Đang gõ dở thì KHÔNG tự đè: hiện dải cảnh báo với hai lựa chọn 'Nạp số mới' / 'Giữ nguyên'. Đo trên trình duyệt thật: đổi ở HMI thì pH min 5.5 -> 6.9 và thời gian tưới 15 -> 31 phút trong ~2 giây, không cần F5; ô đang gõ 7.7 được giữ nguyên; không tràn ngang ở 1440px lẫn 390px.
BUG-02 | Đồng bộ Cấu hình (Web -> HMI) | Nhập thông số ngưỡng mới trên Web, ấn Lưu nhưng màn hình HMI và ESP32 vẫn giữ số cũ. | Route PUT /api/config của Backend Node.js chỉ ghi cấu hình vào SQLite, thiếu logic gọi hàm enqueueCommand để tạo lệnh cho ESP32 kéo về cập nhật. | ĐÃ SỬA (commit cf9bad3). Một điều chỉnh so với mô tả: gửi xuống bằng chuỗi 'SAVE=' mười trường chứ KHÔNG dùng JSON — ESP32 đọc phản hồi vào bộ đệm DynamicJsonDocument 1024 byte, mười khoá JSON chiếm quá nửa. Firmware xử lý được cả hai dạng. Quan trọng: EC phải CHIA 1000 khi gửi xuống (web lưu µS/cm, sketch giữ mS/cm) — gửi thẳng là đặt sai ngưỡng một nghìn lần. Chỉ xếp lệnh khi một trong mười giá trị thật sự đổi, nên sửa hiệu chuẩn bồn nước không đánh thức tủ điện. Đo: 1200 µS/cm đi trọn vòng web → ESP32 → STM32 → web không lệch; bấm Lưu 3 lần liên tiếp gộp còn 1 lệnh mang giá trị cuối.
BUG-03 | Điều khiển (Safety Logic) | Nút Dừng khẩn cấp (E-Stop) trên Web không cắt điện rơ-le ở tủ điện ngay lập tức. | Hàm setEmergencyStop ở Backend chỉ đổi trạng thái mềm sang MANUAL và tắt lẻ tẻ từng van, không tạo mã lệnh ESTOP đích danh để ESP32 kích hoạt ngắt phần cứng. | ĐÃ SỬA (commit cf9bad3), nhưng KHÁC đề xuất ở hai điểm quan trọng. (1) Dùng device_id 'estop', KHÔNG dùng 'system'. enqueueCommand xoá mọi lệnh còn sống cùng device_id, mà /api/system/restart và fetch-now đều đã dùng 'system' — đã đo: lệnh RESTART bị nút 'Lấy dữ liệu ngay' xoá mất. Đặt ESTOP vào đó thì một nút làm mới dữ liệu có thể huỷ lặng lẽ lệnh dừng khẩn cấp. (2) Phải đổi cả THỨ TỰ, không chỉ thêm lệnh. Nguyên nhân sâu hơn mô tả: firmware TỪ CHỐI mọi lệnh bơm/van từ web khi tủ đang ở TỰ ĐỘNG (if systemMode != 0 -> ack false). Thứ tự cũ xếp 9 lệnh TẮT rồi mới tới mode=MANUAL, nên đúng lúc cần nhất thì cả 9 lệnh bị đá về. Nay: estop → mode → các lệnh TẮT (giữ làm lớp đỡ). Cả dàn tắt trong MỘT nhịp hỏi ~3 giây. LƯU Ý TRIỂN KHAI: nạp firmware mới trước hoặc cùng lúc. Bản trước 3d04be2 nhận estop thì đặt webCommandId mà không ack, và clearCommandQueue() không đụng isWaitingAck nên không gì gỡ ra — cú dừng vẫn nổ đúng, nhưng ESP32 đó sẽ không nhận thêm lệnh web nào cho tới khi khởi động lại.
BUG-04 | Giao tiếp (Độ trễ) | Bật/tắt rơ-le Bơm và Van từ Web bị trễ (delay) khoảng 2 giây thiết bị mới phản hồi. | Ý 1 ĐÚNG, Ý 2 SAI. 1. ĐÚNG: WEB_POLL_INTERVAL = 3000ms (esp32_master.ino dòng 58). Đây là toàn bộ nguyên nhân — trung bình chờ 1,5 giây, tệ nhất 3 giây, cộng một lượt LoRa. 2. SAI: PANEL_STAGGER_SECONDS KHÔNG liên quan tới việc bật một rơ-le. Nó chỉ dùng trong enqueueAllDevices (Kiểm tra toàn dàn và Bỏ chọn chế độ). Đã đo: POST /api/devices/pump1/command tạo lệnh có run_after = null, lấy được ngay lập tức — backend không thêm một mili-giây trễ nào. | ĐÃ SỬA (không còn để By Design nữa). Độ trễ đo được giảm từ ~1830 ms xuống ~32 ms. Cách làm: máy chủ GIỮ yêu cầu /api/commands/pending lại (?wait=) thay vì trả mảng rỗng ngay, và trả về đúng lúc có lệnh mới vào hàng đợi. KHÔNG rút ngắn chu kỳ hỏi — đó là cách sai: firmware đặt setReuse(false) nên mỗi lượt hỏi mở một kết nối TLS mới, hỏi dày gấp ba là bắt tay TLS gấp ba, mà tác vụ mạng trên ESP32 chạy TUẦN TỰ nên nó sẽ giành mất chỗ của việc đẩy số đo lên. Mức giữ co giãn theo hạn đẩy số đo kế tiếp, nên nhịp telemetry KHÔNG bị trễ một mili giây nào (đo: 3013 ms trước và sau) và số lượt hỏi lúc rảnh giữ nguyên (0,332 → 0,330 lượt/giây). Mỗi lệnh người dùng bấm tốn thêm đúng một lượt hỏi. Máy chủ cũng tự co mức giữ khi có lệnh hẹn giờ sắp tới hạn, nên nút 'Kiểm tra toàn dàn' vẫn giãn đúng 2 giây một bậc (đo: 9 lệnh, các bậc 2.0 giây). Bỏ trống ?wait thì hành xử y như cũ — firmware bản cũ đang chạy ngoài đồng không bị ảnh hưởng (đo: trả rỗng trong 2 ms). Cơ chế giãn 2 giây chống sụt áp vẫn còn nguyên và VẪN nên khoe với hội đồng — chỉ là khoe ở nút 'Kiểm tra toàn dàn', đúng chỗ nó thật sự chạy.
