minhnhatluongg/lora_project/firmware/esp32_master/esp32_master.ino

#include <HardwareSerial.h>
#include <Wire.h>
#include <Adafruit_GFX.h>
#include <Adafruit_SSD1306.h>
#include <WiFi.h>
#include "time.h"
#include <Preferences.h>
#include <HTTPClient.h>
#include <WiFiClientSecure.h>
#include <ArduinoJson.h>

Preferences preferences;
HardwareSerial loraSerial(1); 
HardwareSerial nextion(2);

#define SCREEN_WIDTH 128
#define SCREEN_HEIGHT 32
#define OLED_RESET -1
#define SCREEN_ADDRESS 0x3C
#define I2C_SDA 9
#define I2C_SCL 10
Adafruit_SSD1306 display(SCREEN_WIDTH, SCREEN_HEIGHT, &Wire, OLED_RESET);

#define LORA_M0 5
#define LORA_M1 6
#define LORA_AUX 8
#define LORA_RX_PIN 18
#define LORA_TX_PIN 17

#define NEXTION_RX 12
#define NEXTION_TX 11

const char* ssid = "DESKTOP-2GO7JB8 5238";
const char* password = "78U5%g77kkkkk";
const char* ntpServer = "time.google.com";
const long gmtOffset_sec = 7 * 3600; 
const int daylightOffset_sec = 0;
const char* BACKEND_BASE = "https://fpoly-smartfarm.id.vn";
const char* DEVICE_API_KEY = "changeme-esp32-secret";
const uint16_t HTTP_CONNECT_TIMEOUT_MS = 1500; 
const uint16_t HTTP_TIMEOUT_MS = 2500;

TaskHandle_t webTaskHandle = NULL;
SemaphoreHandle_t systemMutex = NULL; 
SemaphoreHandle_t queueMutex = NULL;

volatile bool telemetryPending = false, settingsPending = false, deviceStatePending = false, wifiUIUpdatePending = false;
// Co bao cho webTask day tien trinh AUTO/TRON len web. Dat = true o MOI lan
// chuyen trang thai cua hai may trang thai ben duoi; thieu no thi dai tien trinh
// tren trang CONTROL khong bao gio co du lieu.
volatile bool statusReportPending = false;
bool lastWiFiState = false; 
int webCommandId = -1, webAckId = -1;
volatile bool webAckPending = false; 
bool webAckSuccess = false;

unsigned long lastWebPoll = 0, lastTelemetryPost = 0, lastStatePush = 0;
// WEB_POLL_INTERVAL khong con la "do tre cua mot lenh" nua. May chu GIU yeu cau
// lai toi WEB_POLL_HOLD_MS (xem ?wait= trong routes/commands.js) roi tra ve
// NGAY khi co lenh, nen do tre gio xap xi thoi gian truyen chu khong phai chu
// ky hoi. Con so nay chi la khoang nghi giua hai lan mo lai duong cho.
//
// Truoc day de 3000: bam BAT roi cho trung binh 1,5 giay, xau nhat 3 giay.
// Rut ngan chu ky la cach sai — moi luot hoi mo mot ket noi TLS moi
// (setReuse false), ma tac vu mang nay chay TUAN TU nen hoi day gap ba se
// giau mat cho cua viec day so do len.
const unsigned long WEB_POLL_INTERVAL = 150UL, TELEMETRY_INTERVAL = 3000UL, STATE_PUSH_INTERVAL = 5000UL;

// Muc giu KHONG co dinh — no an theo cho trong con lai truoc lan day so do ke
// tiep. Ly do: tac vu mang nay chay TUAN TU, dang giu yeu cau lenh thi khong
// day telemetry duoc. Giu cung 2 giay thi so do bi tre toi 2 giay, va vi moi
// chu ky ngan hon 3 giay nen so luot hoi con TANG (do duoc: +64%) — moi luot
// lai la mot bat tay TLS vi setReuse dang tat.
//
// Giu dung toi luc telemetry toi han thi ca hai deu duoc: so luot hoi giu
// nguyen nhu cu (~1 luot moi 3 giay), so do khong tre mot mili giay nao, ma do
// tre cua lenh tut tu ~1,5 giay xuong con bang thoi gian truyen.
const unsigned long WEB_POLL_HOLD_MIN_MS = 250UL;
const unsigned long WEB_POLL_HOLD_MAX_MS = 3000UL;

String systemPassword; 
unsigned long lastUpdate = 0; 
int systemMode = -1;  
bool pumpState[5] = {false, false, false, false, false}; 
bool valveState[4] = {false, false, false, false};

unsigned long lastLoraRxTime = 0, lastSensorPollTime = 0;
const unsigned long SENSOR_POLL_INTERVAL = 2000UL, LORA_ONLINE_TIMEOUT = 180000UL;
const unsigned long AUTO_POLL_INTERVAL = 300000UL; 

float Temperature = 0.0, Humidity = 0.0, pH_Value = 0.0, EC_Value = 0.0;
uint16_t Nitrogen = 0, Phosphorus = 0, Potassium = 0;
float Dist1 = 0.0, Dist2 = 0.0, Dist3 = 0.0, Dist4 = 0.0;
int RainPercent = 0; 
float AirTemp = 0.0, AirHum = 0.0;
float phMin, phMax, ecMin, ecMax, tempMin, tempMax, humMin, humMax; 
int timeBom, timeNghi;
const float WATER_EMPTY_DIST = 80.0; 
const int RAIN_MAX_PERCENT = 50;

const int QUEUE_SIZE = 15; 
String cmdQueue[QUEUE_SIZE]; 
int queueHead = 0, queueTail = 0;

unsigned long lastSendTime = 0;
const unsigned long TIMEOUT_MS = 2000UL;      
const unsigned long INTER_CMD_DELAY = 100UL;  
const int MAX_RETRIES = 2;                   
int retryCount = 0; 
String currentCommand = ""; 
bool isWaitingAck = false;

const char* EMERGENCY_COMMAND = "<B:ESTOP>";

enum AutoState { AUTO_IDLE, AUTO_OPEN_VALVE, AUTO_WAIT_VALVE_ON, AUTO_WAIT_PUMP_ON, AUTO_IRRIGATING, AUTO_WAIT_PUMP_OFF, AUTO_WAIT_VALVE_OFF, AUTO_WAIT_RESTING_CMD, AUTO_RESTING };
AutoState autoState = AUTO_IDLE; 
unsigned long autoStateTimer = 0;
int currentValveIdx = 0; 

enum MixState { MIX_IDLE, MIX_START_PUMP3, MIX_PUMPING_WATER, MIX_STOP_PUMP3, MIX_WAIT_STABLE, MIX_START_DOSING, MIX_DOSING_NUTRIENT, MIX_STOP_DOSING };
MixState mixState = MIX_IDLE; 
unsigned long mixStateTimer = 0; 
bool isMixingReady = false;

int currentPage = 0; 

// Mo phong muc nuoc bon tron, danh cho luc DEMO tren ban khong co cam bien.
//
// Dat = true thi Dist4 bi GHI DE bang so mo phong moi giay, nen man hinh khong
// con hien so do that nua. Mac dinh = false: doc that tu cam bien sieu am qua
// LoRa. Doi mot dong nay la du de chuyen qua lai.
const bool SIMULATE_TANK_LEVEL = false;
float simDist4 = 80.0; 

String getValue(String data, char separator, int index) {
  int found = 0;
  int startIndex = 0;
  int endIndex = -1;
  
  for (int i = 0; i < data.length(); i++) {
    if (data.charAt(i) == separator) {
      endIndex = i;
      if (found == index) {
        return data.substring(startIndex, endIndex);
      }
      startIndex = i + 1;
      found++;
    }
  }
  if (found == index) {
    return data.substring(startIndex);
  }
  return "";
}

void sendNextionCmd(const String& cmd) { nextion.print(cmd); nextion.write(0xFF); nextion.write(0xFF); nextion.write(0xFF); }
void sendText(const String& obj, const String& txt) { 
  Serial.println("[TX] " + obj + " = " + txt);
  nextion.print(obj + "=\"" + txt + "\""); 
  nextion.write(0xFF); nextion.write(0xFF); nextion.write(0xFF); 
}
void sendValue(const String& obj, int val) { sendNextionCmd(obj + "=" + String(val)); }

void updateOLED(const String& line1, const String& line2) {
  display.clearDisplay(); display.setTextSize(1); display.setTextColor(SSD1306_WHITE);
  display.setCursor(0, 0); display.println(line1); 
  display.setCursor(0, 16); display.println(line2); 
  display.display();
}

// ================================================================
// BIẾN VÀ HÀM HỖ TRỢ OLED 4 DÒNG
// ================================================================
unsigned long lastAutoOLEDRefresh = 0;
const unsigned long AUTO_OLED_REFRESH_INTERVAL = 1000UL; 

void updateOLED4(const String& line1, const String& line2, const String& line3, const String& line4) {
  display.clearDisplay(); 
  display.setTextSize(1); 
  display.setTextColor(SSD1306_WHITE);
  display.setCursor(0, 0);  display.println(line1);
  display.setCursor(0, 8);  display.println(line2);
  display.setCursor(0, 16); display.println(line3);
  display.setCursor(0, 24); display.println(line4);
  display.display();
}

void showAutoStep(const String& l1, const String& l2, const String& l3, const String& l4) {
  updateOLED4(l1, l2, l3, l4);
  lastAutoOLEDRefresh = millis();
}

bool autoOLEDShouldTick() {
  if (millis() - lastAutoOLEDRefresh >= AUTO_OLED_REFRESH_INTERVAL) {
    lastAutoOLEDRefresh = millis();
    return true;
  }
  return false;
}

void updateWiFiIcon() { sendNextionCmd("vis pwifi," + String(WiFi.status() == WL_CONNECTED ? 0 : 1)); }

void updateDashboard() {
  sendText("t0.txt", String(Temperature, 1)); sendText("t1.txt", String(Humidity, 1));
  sendText("t2.txt", String(pH_Value, 1)); sendText("t3.txt", String(EC_Value, 2));
  sendText("t4.txt", String(Potassium)); sendText("t5.txt", String(Nitrogen));
  sendText("t6.txt", String(Dist1, 1)); sendText("t7.txt", String(Dist2, 1));
  sendText("t8.txt", String(Dist3, 1)); sendText("t9.txt", String(Dist4, 1));
  String rainStatus = (RainPercent < 10) ? "Khong mua" : (RainPercent < 40) ? "Mua nho" : (RainPercent < 70) ? "Mua vua" : "Mua to";
  sendText("t12.txt", rainStatus); sendText("t11.txt", String(AirTemp, 1)); sendText("t10.txt", String(AirHum, 1));
}

void updateNextionControlStates() {
  if (systemMode == 1) { sendValue("page3.bt10.val", 1); sendValue("page3.bt9.val", 0); } 
  else if (systemMode == 0) { sendValue("page3.bt10.val", 0); sendValue("page3.bt9.val", 1); } 
  else { sendValue("page3.bt10.val", 0); sendValue("page3.bt9.val", 0); }
  xSemaphoreTake(systemMutex, portMAX_DELAY);
  for (int i = 0; i < 5; i++) sendValue("page3.bt" + String(i) + ".val", pumpState[i] ? 1 : 0);
  for (int i = 0; i < 4; i++) sendValue("page3.bt" + String(i + 5) + ".val", valveState[i] ? 1 : 0);
  xSemaphoreGive(systemMutex);
}

void updateClock() {
  struct tm t; if (!getLocalTime(&t)) return; char str[20];
  snprintf(str, sizeof(str), "%02d:%02d:%02d", t.tm_hour, t.tm_min, t.tm_sec); sendText("time.txt", str);
  snprintf(str, sizeof(str), "%02d/%02d/%04d", t.tm_mday, t.tm_mon + 1, t.tm_year + 1900); sendText("date.txt", str);
}

void clearCommandQueue() {
  if (queueMutex != NULL) xSemaphoreTake(queueMutex, portMAX_DELAY);
  queueHead = 0; queueTail = 0; for (int i = 0; i < QUEUE_SIZE; i++) cmdQueue[i] = "";
  if (queueMutex != NULL) xSemaphoreGive(queueMutex);
}

bool isCommandInQueue(const String& cmd) {
  bool found = false;
  xSemaphoreTake(queueMutex, portMAX_DELAY);
  int i = queueHead;
  while (i != queueTail) {
    if (cmdQueue[i] == cmd) { found = true; break; }
    i = (i + 1) % QUEUE_SIZE;
  }
  xSemaphoreGive(queueMutex);
  return found;
}

bool enqueueCommand(const String& cmd) {
  if (cmd.length() == 0) return false; bool success = false;
  xSemaphoreTake(queueMutex, portMAX_DELAY);
  int lastItemIndex = (queueTail - 1 + QUEUE_SIZE) % QUEUE_SIZE;
  if (queueHead != queueTail && cmdQueue[lastItemIndex] == cmd) { xSemaphoreGive(queueMutex); return false; }
  int nextTail = (queueTail + 1) % QUEUE_SIZE;
  if (nextTail != queueHead) { cmdQueue[queueTail] = cmd; queueTail = nextTail; success = true; }
  xSemaphoreGive(queueMutex); return success;
}

void safelySwitchMode(int newMode) {
  clearCommandQueue(); 
  xSemaphoreTake(systemMutex, portMAX_DELAY); systemMode = newMode;
  if (newMode == 0) { for (int i = 0; i < 5; i++) pumpState[i] = false; for (int i = 0; i < 4; i++) valveState[i] = false; }
  xSemaphoreGive(systemMutex);
  autoState = AUTO_IDLE; mixState = MIX_IDLE; isMixingReady = false;

  if (newMode == 0) { 
    updateOLED("CHUYEN CHE DO", "-> MANUAL"); 
    if (currentPage == 3) updateNextionControlStates(); 
    loraSerial.println(EMERGENCY_COMMAND); delay(50); 
  } 
  else { 
    updateOLED("CHE DO AUTO", "Dang hoat dong..."); 
    if (currentPage == 3) updateNextionControlStates(); 
    lastLoraRxTime = 0; 
    lastSensorPollTime = millis() - AUTO_POLL_INTERVAL; 
  }
  enqueueCommand(newMode == 1 ? "<B:SET_MODE=AUTO>" : "<B:SET_MODE=MANUAL>");
}

void enqueueEmergencyStop() {
  clearCommandQueue(); 
  xSemaphoreTake(systemMutex, portMAX_DELAY); systemMode = 0; 
  for (int i = 0; i < 5; i++) pumpState[i] = false; for (int i = 0; i < 4; i++) valveState[i] = false;
  xSemaphoreGive(systemMutex);
  autoState = AUTO_IDLE; mixState = MIX_IDLE; isMixingReady = false;
  loraSerial.println(EMERGENCY_COMMAND); delay(50); loraSerial.println(EMERGENCY_COMMAND);
  updateOLED("EMERGENCY STOP", "Ngat toan he thong"); 
  if (currentPage == 3) updateNextionControlStates();

  // Day trang thai TAT cua toan bo bom/van len web NGAY, khong doi nhip 5 giay:
  // dung khan cap ma trang web con ve cong tac mau xanh them vai giay la sai.
  deviceStatePending = true;
  statusReportPending = true;
}

void setWebAckResult(int id, bool success) {
  if (id < 0) return; xSemaphoreTake(systemMutex, portMAX_DELAY); webAckId = id; webAckSuccess = success;
  webAckPending = true; webCommandId = -1; xSemaphoreGive(systemMutex);
}

void applyConfirmedState(String cmdBody) {
  xSemaphoreTake(systemMutex, portMAX_DELAY);
  if (cmdBody == "SET_MODE=AUTO") { systemMode = 1; } 
  else if (cmdBody == "SET_MODE=MANUAL") { systemMode = 0; } 
  else if (cmdBody.startsWith("ON")) { 
    int pin = cmdBody.substring(2).toInt(); 
    if (pin >= 1 && pin <= 5) pumpState[pin - 1] = true; 
    else if (pin >= 6 && pin <= 9) valveState[pin - 6] = true; 
  } 
  else if (cmdBody.startsWith("OFF")) { 
    int pin = cmdBody.substring(3).toInt(); 
    if (pin >= 1 && pin <= 5) pumpState[pin - 1] = false; 
    else if (pin >= 6 && pin <= 9) valveState[pin - 6] = false; 
  } 
  xSemaphoreGive(systemMutex);
  
  if (currentPage == 3) updateNextionControlStates(); 
  deviceStatePending = true;
}

// KHÔI PHỤC LẠI HÀM LORA QUEUE GỐC (Tránh lỗi kẹt buffer thủ công)
void processLoRaQueue() {
  unsigned long now = millis();
  if (digitalRead(LORA_AUX) == LOW) return;

  if (isWaitingAck) {
    if (now - lastSendTime >= TIMEOUT_MS) {
      retryCount++;
      if (retryCount <= MAX_RETRIES) { 
        loraSerial.println(currentCommand); 
        lastSendTime = now; 
      } 
      else {
        if (webCommandId >= 0) setWebAckResult(webCommandId, false);
        isWaitingAck = false; retryCount = 0;
        
        if (currentCommand == "<A:GET_DATA>") updateOLED("LORA LOI", "STM32 Khong Data");
        else updateOLED("LORA LOI", "Khong phan hoi"); 
        
        if (currentPage == 3) updateNextionControlStates(); 
        currentCommand = "";
      }
    } 
    return; 
  }

  if (now - lastSendTime < INTER_CMD_DELAY) return;
  String commandToSend = "";
  xSemaphoreTake(queueMutex, portMAX_DELAY);
  if (queueHead != queueTail) { 
    commandToSend = cmdQueue[queueHead]; 
    cmdQueue[queueHead] = ""; 
    queueHead = (queueHead + 1) % QUEUE_SIZE; 
  }
  xSemaphoreGive(queueMutex);

  if (commandToSend.length() > 0) {
    currentCommand = commandToSend; 
    loraSerial.println(currentCommand); 
    lastSendTime = now; 
    isWaitingAck = true; 
    
    // OLED Delay cực kỳ quan trọng cho mạch UART đẩy data LoRa E32
    if(currentCommand != "<A:GET_DATA>") updateOLED("LORA TX:", currentCommand);
  }
}

// ================================================================
// THUẬT TOÁN TRỘN PHÂN
// ================================================================
void handleAutoMixingLogic() {
  if (systemMode != 1) return; // Đã loại bỏ Timeout 5s khiến hệ thống đóng băng
  unsigned long now = millis();
  const float WATER_FULL_DIST = 20.0; 

  switch (mixState) {
    case MIX_IDLE: 
      if (!isMixingReady) {
        mixState = MIX_START_PUMP3; 
        showAutoStep("TRON PHAN: B1", "Kiem tra muc nuoc...", "", "");
      }
      break;

    case MIX_START_PUMP3:
      if (Dist4 > 0 && Dist4 <= WATER_FULL_DIST) {
        mixState = MIX_START_DOSING; 
        statusReportPending = true;
        showAutoStep("TRON PHAN: B2", "Bon da day nuoc", "Chuyen cham phan...", "");
      } else {
        enqueueCommand("<B:ON3>"); 
        mixStateTimer = now; 
        mixState = MIX_PUMPING_WATER; 
        statusReportPending = true;
        showAutoStep("TRON PHAN: B1", "Dang cap nuoc...", "Muc: " + String(Dist4, 1) + "cm", "Cho day bon (<20cm)");
      }
      break;

    case MIX_PUMPING_WATER: {
      unsigned long elapsed = now - mixStateTimer;
      if ((Dist4 > 0 && Dist4 <= WATER_FULL_DIST) || elapsed >= 1200000UL) { 
        mixState = MIX_STOP_PUMP3; 
      } else if (autoOLEDShouldTick()) {
        updateOLED4("TRON PHAN: B1", "Dang cap nuoc...", "Muc: " + String(Dist4, 1) + "cm", "Cho day bon (<20cm)");
      }
      break;
    }

    case MIX_STOP_PUMP3:
      enqueueCommand("<B:OFF3>"); 
      enqueueCommand("<B:ON5>"); 
      mixStateTimer = now; 
      mixState = MIX_WAIT_STABLE; 
      statusReportPending = true;
      showAutoStep("TRON PHAN: B2", "Khuay on dinh nuoc", "EC: " + String(EC_Value, 2), "Thoi gian: 20s");
      break;

    case MIX_WAIT_STABLE: {
      unsigned long elapsed = now - mixStateTimer;
      if (elapsed >= 20000UL) {
        enqueueCommand("<B:OFF5>"); 
        if (EC_Value < ecMin) { 
          mixState = MIX_START_DOSING; 
          statusReportPending = true;
        } 
        else if (EC_Value > ecMax) { 
          mixState = MIX_START_PUMP3; 
          showAutoStep("TRON PHAN", "EC cao -> Pha loang", "Cap them nuoc...", "");
        } 
        else { 
          isMixingReady = true; 
          mixState = MIX_IDLE; 
          statusReportPending = true;
          showAutoStep("TRON PHAN: XONG", "EC dat chuan on dinh", "San sang tuoi", "");
        }
      } else if (autoOLEDShouldTick()) {
        unsigned long remainSec = (20000UL - elapsed) / 1000UL;
        updateOLED4("TRON PHAN: B2", "Khuay on dinh nuoc", "EC: " + String(EC_Value, 2), "Con lai: " + String(remainSec) + "s");
      }
      break;
    }

    case MIX_START_DOSING:
      enqueueCommand("<B:ON1>"); 
      enqueueCommand("<B:ON2>"); 
      enqueueCommand("<B:ON5>"); 
      mixStateTimer = now; 
      mixState = MIX_DOSING_NUTRIENT; 
      statusReportPending = true;
      showAutoStep("TRON PHAN: B3", "Cham phan + Khuay", "EC: " + String(EC_Value, 2), "Thoi gian: 3s");
      break;

    case MIX_DOSING_NUTRIENT: {
      unsigned long elapsed = now - mixStateTimer;
      if (elapsed >= 3000UL) { 
        mixState = MIX_STOP_DOSING; 
        statusReportPending = true;
      } else if (autoOLEDShouldTick()) {
        unsigned long remainSec = (3000UL - elapsed) / 1000UL;
        updateOLED4("TRON PHAN: B3", "Cham phan + Khuay", "EC: " + String(EC_Value, 2), "Con lai: " + String(remainSec) + "s");
      }
      break;
    }

    case MIX_STOP_DOSING:
      enqueueCommand("<B:OFF1>"); 
      enqueueCommand("<B:OFF2>"); 
      mixStateTimer = now; 
      mixState = MIX_WAIT_STABLE; 
      statusReportPending = true;
      showAutoStep("TRON PHAN: B4", "Khuay hoa tan phan", "EC: " + String(EC_Value, 2), "Thoi gian: 20s");
      break;
  }
}

// ================================================================
// THUẬT TOÁN TƯỚI SONG SONG
// ================================================================
void handleAutoIrrigationLogic() {
  if (systemMode != 1) return; 

  // KHOA CHEO AN TOAN — mua to thi cat ngang, khong doi tuoi xong chu ky.
  // Kiem o DAU ham chu khong chi luc bat dau: troi do mua giua chung ma van tuoi
  // tiep thi vua phi nuoc vua ung goc. Phan can nuoc bon tron da duoc kiem rieng
  // trong AUTO_IDLE va AUTO_IRRIGATING nen o day chi lo chuyen mua.
  if (RainPercent >= RAIN_MAX_PERCENT) {
    if (autoState != AUTO_IDLE) {
      enqueueCommand("<B:OFF4>");                                   // bom tuoi
      enqueueCommand("<B:OFF" + String(6 + currentValveIdx) + ">"); // van dang mo
      autoState = AUTO_IDLE;
      statusReportPending = true;
      showAutoStep("KHOA AN TOAN", "Troi dang mua to!", "Da ngat bom va van", "Cho tanh mua...");
    }
    return;
  }

  unsigned long now = millis();
  switch (autoState) {
    case AUTO_IDLE: 
      if (Humidity <= humMin && isMixingReady) { 
        if (Dist4 > 0 && Dist4 >= WATER_EMPTY_DIST) {
          if (autoOLEDShouldTick()) updateOLED4("TUOI CAY: LOI", "Can nuoc trong bon!", "Vui long cap nuoc...", "");
          isMixingReady = false; 
          return;
        }
        currentValveIdx = 0; 
        autoState = AUTO_OPEN_VALVE; 
        statusReportPending = true;
      } 
      break;

    case AUTO_OPEN_VALVE:
      enqueueCommand("<B:ON" + String(6 + currentValveIdx) + ">"); 
      if (currentValveIdx == 0) enqueueCommand("<B:ON4>"); 
      autoStateTimer = now; 
      autoState = AUTO_IRRIGATING; 
      statusReportPending = true;
      showAutoStep("TUOI CAY: AUTO", "Tuoi Van " + String(currentValveIdx + 1), "Am do: " + String(Humidity, 1) + "%", "Thoi gian: " + String(timeBom) + "p");
      break;

    case AUTO_IRRIGATING: {
      unsigned long maxMs = (unsigned long)timeBom * 60000UL; 
      unsigned long elapsed = now - autoStateTimer;
      
      if (Dist4 > 0 && Dist4 >= WATER_EMPTY_DIST) {
        enqueueCommand("<B:OFF4>");
        enqueueCommand("<B:OFF" + String(6 + currentValveIdx) + ">");
        autoState = AUTO_IDLE;
        statusReportPending = true;
        isMixingReady = false;
        showAutoStep("BAO DONG", "Can nuoc khi tuoi!", "Da ngat he thong", "");
        break;
      }

      if (elapsed >= maxMs) { 
        autoState = AUTO_WAIT_RESTING_CMD; 
        statusReportPending = true;
      } else if (autoOLEDShouldTick()) {
        unsigned long remainSec = (maxMs - elapsed) / 1000UL;
        updateOLED4("TUOI CAY: AUTO", "Dang tuoi Van " + String(currentValveIdx + 1), "Am do: " + String(Humidity, 1) + "%", "Con lai: " + String(remainSec) + "s");
      }
      break;
    }

    case AUTO_WAIT_RESTING_CMD:
      currentValveIdx++; 
      
      if (currentValveIdx < 4) { 
          enqueueCommand("<B:ON" + String(6 + currentValveIdx) + ">"); 
          autoStateTimer = now;
          autoState = AUTO_WAIT_VALVE_OFF;
          statusReportPending = true;
          showAutoStep("TUOI CAY: AUTO", "Chuyen Van " + String(currentValveIdx + 1), "Dang chong soc ap...", "");
      } 
      else { 
          enqueueCommand("<B:OFF4>"); 
          enqueueCommand("<B:OFF9>"); 
          
          if (Humidity < humMax) { 
              autoState = AUTO_RESTING;
              statusReportPending = true;
              autoStateTimer = now; 
              showAutoStep("TUOI CAY: AUTO", "Da tuoi xong 4 van", "Dang nghi ngoi...", "Thoi gian: " + String(timeNghi) + "p"); 
          } 
          else { 
              autoState = AUTO_IDLE; 
              statusReportPending = true;
              isMixingReady = false; 
              showAutoStep("TUOI CAY: XONG", "Am do dat chuan", "Hoan thanh chu ky", ""); 
          } 
      } 
      break;

    case AUTO_WAIT_VALVE_OFF: {
      unsigned long elapsed = now - autoStateTimer;
      if (elapsed >= 1000UL) { 
         enqueueCommand("<B:OFF" + String(6 + currentValveIdx - 1) + ">"); 
         autoStateTimer = now; 
         autoState = AUTO_IRRIGATING; 
         statusReportPending = true;
      }
      break;
    }

    case AUTO_RESTING: {
      unsigned long maxMs = (unsigned long)timeNghi * 60000UL;
      unsigned long elapsed = now - autoStateTimer;
      if (elapsed >= maxMs) { 
        autoState = AUTO_IDLE; 
        statusReportPending = true;
      } else if (autoOLEDShouldTick()) {
        unsigned long remainSec = (maxMs - elapsed) / 1000UL;
        updateOLED4("TUOI CAY: AUTO", "Dang nghi ngoi...", "Am do: " + String(Humidity, 1) + "%", "Con lai: " + String(remainSec) + "s");
      }
      break;
    }
      
    default:
      autoState = AUTO_IDLE;
      statusReportPending = true;
      break;
  }
}

// Client TLS dung chung cho moi loi goi HTTPS.
//
// Chi MOT tac vu (webTask) goi beginRequest, nen dung chung mot client la an
// toan — khong co hai luong cung mo mot ket noi.
//
// setInsecure() = KHONG kiem chung chi may chu. Danh doi co that: mat kha nang
// chong gia mao (ai chen giua duong truyen deu doc duoc x-api-key). Doi lai,
// khong phai nhung chung chi CA vao firmware — ma chung chi Let's Encrypt doi
// moi 90 ngay, nhung cung thi den han la thiet bi ngoai dong chet ket noi va
// phai thao ra nap lai. Voi do an thi danh doi nay hop ly; muon chat hon thi
// dung setCACert() voi chung chi goc ISRG Root X1.
static WiFiClientSecure secureClient;
static bool secureClientReady = false;

// Tu nhan biet theo BACKEND_BASE, khong cam cung. Doi lai "http://..." la chay
// duong thuong ngay, khong phai sua them dong nao.
static inline bool backendUsesHttps() {
  return String(BACKEND_BASE).startsWith("https://");
}

bool beginRequest(HTTPClient& http, const char* path) {
  if (WiFi.status() != WL_CONNECTED) return false;
  http.setConnectTimeout(HTTP_CONNECT_TIMEOUT_MS); http.setTimeout(HTTP_TIMEOUT_MS); http.setReuse(false);

  String url = String(BACKEND_BASE) + path;
  bool opened;
  if (backendUsesHttps()) {
    if (!secureClientReady) { secureClient.setInsecure(); secureClientReady = true; }
    opened = http.begin(secureClient, url);
  } else {
    opened = http.begin(url);
  }
  if (!opened) return false;

  http.addHeader("x-api-key", DEVICE_API_KEY); return true;
}

void ackWebCommand(int id, bool success) {
  if (id < 0 || WiFi.status() != WL_CONNECTED) return; HTTPClient http;
  if (!beginRequest(http, ("/api/commands/" + String(id) + "/ack").c_str())) return;
  http.addHeader("Content-Type", "application/json"); http.POST(success ? "{\"success\":true}" : "{\"success\":false}"); http.end();
}

void pushSettingsToWeb() {
  if (WiFi.status() != WL_CONNECTED) return; DynamicJsonDocument doc(512);
  doc["phMin"] = phMin; doc["phMax"] = phMax;
  // Cung ly do nhu doc["ec"] o tren: web luu nguong EC theo uS/cm.
  doc["ecMin"] = ecMin * 1000.0; doc["ecMax"] = ecMax * 1000.0;
  doc["tempMin"] = tempMin; doc["tempMax"] = tempMax; doc["humMin"] = humMin; doc["humMax"] = humMax;
  doc["timeBom"] = timeBom; doc["timeNghi"] = timeNghi;
  String body; serializeJson(doc, body); HTTPClient http;
  if (beginRequest(http, "/api/config/thresholds")) { http.addHeader("Content-Type", "application/json"); http.POST(body); http.end(); }
}

void postTelemetryToWeb() {
  if (WiFi.status() != WL_CONNECTED) return; DynamicJsonDocument doc(1024);
  xSemaphoreTake(systemMutex, portMAX_DELAY);
  doc["temperature"] = Temperature; doc["humidity"] = Humidity; doc["ph"] = pH_Value;
  // EC: NHAN 1000 truoc khi gui len web.
  // STM32 da chia 1000 khi doc thanh ghi Modbus nen EC_Value o day la mS/cm
  // (vd 1.48). Nhung backend luu EC theo uS/cm va giao dien chia 1000 de hien
  // mS/cm — gui thang so mS/cm len thi trang Dashboard hien 0.00 mS/cm.
  // Doi ngay tai ranh gioi web, de may trang thai ben trong ESP32 va man Nextion
  // van dung mS/cm nhu cu.
  doc["ec"] = EC_Value * 1000.0;
  // Cuong do song WiFi giua ESP32 va router, don vi dBm (luon am, cang gan 0
  // cang manh). Do duoc ngay khong can them phan cung nao.
  //
  // KHONG phai song LoRa. Module E32 noi qua UART khong co lenh doc RSSI, nen
  // doan ESP32 <-> node cam bien khong do duoc — muon do phai doi sang module
  // dong E22. Gui rieng mot truong `wifi_rssi` de khong ai nham hai doan duong
  // truyen voi nhau.
  doc["wifi_rssi"] = WiFi.RSSI();
  doc["n"] = Nitrogen; doc["p"] = Phosphorus; doc["k"] = Potassium; doc["dist1"] = Dist1; doc["dist2"] = Dist2; doc["dist3"] = Dist3; doc["dist4"] = Dist4;
  doc["air_temp"] = AirTemp; doc["air_hum"] = AirHum; doc["rain"] = RainPercent; doc["slave_online"] = (lastLoraRxTime > 0 && millis() - lastLoraRxTime < LORA_ONLINE_TIMEOUT);
  xSemaphoreGive(systemMutex); doc["sensor_status"] = "OK";
  String body; serializeJson(doc, body); HTTPClient http;
  if (beginRequest(http, "/api/telemetry")) { http.addHeader("Content-Type", "application/json"); http.POST(body); http.end(); }
}

void pushDeviceStateToWeb() {
  if (WiFi.status() != WL_CONNECTED) return; DynamicJsonDocument doc(512);
  xSemaphoreTake(systemMutex, portMAX_DELAY);
  for (int i = 0; i < 5; i++) doc["pump" + String(i + 1)] = pumpState[i] ? "ON" : "OFF";
  for (int i = 0; i < 4; i++) doc["van" + String(i + 1)] = valveState[i] ? "ON" : "OFF";
  xSemaphoreGive(systemMutex);
  String body; serializeJson(doc, body); HTTPClient http;
  if (beginRequest(http, "/api/devices/state")) { http.addHeader("Content-Type", "application/json"); http.POST(body); http.end(); }
}

// Bao cho web biet may trang thai duoi ruong dang o buoc nao. Day la nguon duy
// nhat cua autoState/mixState tren trang CONTROL — va cung la duong DUY NHAT de
// mot lan doi che do tren man Nextion di nguoc len duoc web.
void pushStatusReportToWeb() {
  if (WiFi.status() != WL_CONNECTED) return;
  DynamicJsonDocument doc(512);

  xSemaphoreTake(systemMutex, portMAX_DELAY);
  doc["mode"] = (systemMode == 1) ? "AUTO" : "MANUAL";
  doc["autoState"] = (int)autoState;
  doc["mixState"] = (int)mixState;
  doc["mixReady"] = isMixingReady;
  xSemaphoreGive(systemMutex);

  String body; serializeJson(doc, body);
  HTTPClient http;
  if (beginRequest(http, "/api/status/report")) {
    http.addHeader("Content-Type", "application/json");
    http.POST(body);
    http.end();
  }
}

void pollWebCommands(unsigned long holdMs) {
  if (WiFi.status() != WL_CONNECTED || webCommandId != -1) return; HTTPClient http;
  if (!beginRequest(http, ("/api/commands/pending?limit=1&wait=" + String(holdMs)).c_str())) return;
  // Han doc rieng cho luot nay: may chu co the giu toi holdMs truoc khi tra
  // loi, con HTTP_TIMEOUT_MS mac dinh (2500) thi qua sat.
  http.setTimeout(holdMs + 1500);
  if (http.GET() != 200) { http.end(); return; } String response = http.getString(); http.end();
  DynamicJsonDocument doc(1024); if (deserializeJson(doc, response)) return;

  for (JsonObject cmd : doc.as<JsonArray>()) {
    int id = cmd["id"] | -1; String devId = cmd["device_id"].as<String>(); String action = cmd["action"].as<String>();
    if (id < 0) continue;

    if (devId == "mode") { safelySwitchMode(action == "AUTO" ? 1 : 0); webCommandId = id; return; }
    
    // So khop RONG va tra ack NGAY. Ban hep truoc day (action == "ESTOP") bo sot
    // cac dang viet khac va dat webCommandId thay vi tra ack, khien trang web
    // treo cho mot lenh khong bao gio duoc xac nhan.
    String devIdUp = devId; devIdUp.toUpperCase();
    String actionUp = action; actionUp.toUpperCase();
    if (actionUp.indexOf("ESTOP") >= 0 || devIdUp.indexOf("ESTOP") >= 0 || actionUp == "STOP") {
      enqueueEmergencyStop();
      setWebAckResult(id, true);
      return;
    }

    if (action == "FETCH_NOW" || action == "GET_DATA" || devId == "data" || devId == "system") {
      if (!isCommandInQueue("<A:GET_DATA>")) {
        enqueueCommand("<A:GET_DATA>");
        updateOLED("WEB CMD", "Lay du lieu...");
      }
      webCommandId = id;
      return;
    }

    if (devId == "settings" || action.startsWith("SAVE=") || action.startsWith("{")) {
      if (action.startsWith("{")) {
        DynamicJsonDocument conf(512);
        if (!deserializeJson(conf, action)) {
          phMin = conf["phMin"] | phMin; phMax = conf["phMax"] | phMax;
          ecMin = conf["ecMin"] | ecMin; ecMax = conf["ecMax"] | ecMax;
          tempMin = conf["tempMin"] | tempMin; tempMax = conf["tempMax"] | tempMax;
          humMin = conf["humMin"] | humMin; humMax = conf["humMax"] | humMax;
          timeBom = conf["timeBom"] | timeBom; timeNghi = conf["timeNghi"] | timeNghi;
        }
      } 
      else {
        String data = action;
        if (data.startsWith("SAVE=")) data = data.substring(5);
        phMin = getValue(data, ',', 0).toFloat(); phMax = getValue(data, ',', 1).toFloat();
        ecMin = getValue(data, ',', 2).toFloat(); ecMax = getValue(data, ',', 3).toFloat();
        tempMin = getValue(data, ',', 4).toFloat(); tempMax = getValue(data, ',', 5).toFloat();
        humMin = getValue(data, ',', 6).toFloat(); humMax = getValue(data, ',', 7).toFloat();
        timeBom = getValue(data, ',', 8).toInt(); timeNghi = getValue(data, ',', 9).toInt();
      }

      if (timeBom > 0) {
        preferences.begin("system_data", false);
        preferences.putFloat("phMin", phMin); preferences.putFloat("phMax", phMax); 
        preferences.putFloat("ecMin", ecMin); preferences.putFloat("ecMax", ecMax);
        preferences.putFloat("tempMin", tempMin); preferences.putFloat("tempMax", tempMax); 
        preferences.putFloat("humMin", humMin); preferences.putFloat("humMax", humMax);
        preferences.putInt("timeBom", timeBom); preferences.putInt("timeNghi", timeNghi); 
        preferences.end();
      }

      // Day nguong moi XUONG node cam bien. Thieu dong nay thi doi nguong tren
      // web chi thay doi ban sao trong ESP32; STM32 van chay nguong cu, va hai
      // dau se bat dong y ve luc nao la "dat nguong".
      String dataToSave = String(phMin, 1) + "," + String(phMax, 1) + "," +
                          String(ecMin, 1) + "," + String(ecMax, 1) + "," +
                          String(tempMin, 1) + "," + String(tempMax, 1) + "," +
                          String(humMin, 1) + "," + String(humMax, 1) + "," +
                          String(timeBom) + "," + String(timeNghi);
      enqueueCommand("<SET_DATA=" + dataToSave + ">");

      if (currentPage == 2) updateNextionSettingsPage();
      setWebAckResult(id, true); 
      return;
    }

    if (devId.startsWith("pump") || devId.startsWith("van")) {
      if (systemMode != 0) { setWebAckResult(id, false); return; }
      bool isON = (action == "ON"); int relayPin = -1;
      
      if (devId.startsWith("pump")) { relayPin = devId.substring(4).toInt(); } 
      else if (devId.startsWith("van")) { relayPin = devId.substring(3).toInt() + 5; }
      
      if (relayPin >= 1 && relayPin <= 9) { 
        if (enqueueCommand(isON ? "<B:ON" + String(relayPin) + ">" : "<B:OFF" + String(relayPin) + ">")) { 
            webCommandId = id; 
        } 
        return; 
      }
    }
  }
}

void webTask(void* parameter) {
  unsigned long lastWiFiRetry = 0; 
  for (;;) {
    unsigned long now = millis(); bool currentWiFiState = (WiFi.status() == WL_CONNECTED);
    if (currentWiFiState != lastWiFiState) { lastWiFiState = currentWiFiState; xSemaphoreTake(systemMutex, portMAX_DELAY); wifiUIUpdatePending = true; xSemaphoreGive(systemMutex); }
    if (!currentWiFiState && (now - lastWiFiRetry >= 10000UL)) { lastWiFiRetry = now; WiFi.disconnect(); WiFi.begin(ssid, password); }

    bool sendAck = false; int ackId = -1; bool ackSuccess = false;
    xSemaphoreTake(systemMutex, portMAX_DELAY);
    if (webAckPending) { sendAck = true; ackId = webAckId; ackSuccess = webAckSuccess; webAckPending = false; webAckId = -1; }
    xSemaphoreGive(systemMutex);

    if (sendAck) ackWebCommand(ackId, ackSuccess);
    if (now - lastWebPoll >= WEB_POLL_INTERVAL) {
      lastWebPoll = now;
      // Cho trong con lai truoc lan day so do ke tiep. Con no thi giu bang do,
      // khong con thi hoi nhanh roi tra ve ngay de telemetry di truoc.
      unsigned long since = now - lastTelemetryPost;
      unsigned long budget = since >= TELEMETRY_INTERVAL ? 0UL : TELEMETRY_INTERVAL - since;
      if (budget > WEB_POLL_HOLD_MAX_MS) budget = WEB_POLL_HOLD_MAX_MS;
      if (budget < WEB_POLL_HOLD_MIN_MS) budget = WEB_POLL_HOLD_MIN_MS;
      pollWebCommands(budget);
    }
    if ((telemetryPending || now - lastTelemetryPost >= TELEMETRY_INTERVAL) && currentWiFiState) { lastTelemetryPost = now; telemetryPending = false; postTelemetryToWeb(); }
    if (settingsPending && currentWiFiState) { settingsPending = false; pushSettingsToWeb(); }
    if ((deviceStatePending || now - lastStatePush >= STATE_PUSH_INTERVAL) && currentWiFiState) { lastStatePush = now; deviceStatePending = false; pushDeviceStateToWeb(); }
    if (statusReportPending && currentWiFiState) {
      statusReportPending = false;
      pushStatusReportToWeb();
    }
    vTaskDelay(pdMS_TO_TICKS(20));
  }
}

void processLoRaData(const String& incomingData) {
  if (!incomingData.startsWith("<A:DATA:") || !incomingData.endsWith(">")) return;
  String raw = incomingData.substring(8, incomingData.length() - 1);
  xSemaphoreTake(systemMutex, portMAX_DELAY);
  
  Temperature = getValue(raw, ',', 0).toFloat(); Humidity = getValue(raw, ',', 1).toFloat();
  EC_Value = getValue(raw, ',', 2).toFloat(); 
  pH_Value = getValue(raw, ',', 3).toFloat();
  Nitrogen = getValue(raw, ',', 4).toInt(); Phosphorus = getValue(raw, ',', 5).toInt();
  Potassium = getValue(raw, ',', 6).toInt(); 
  Dist1 = getValue(raw, ',', 7).toFloat(); 
  Dist2 = getValue(raw, ',', 8).toFloat(); 
  Dist3 = getValue(raw, ',', 9).toFloat(); 
  // Doc lai Dist4 tu goi LoRa. STM32 CO gui no o vi tri 10
  // (xem prepareLoraSensorData trong stm32_sensor_node.ino), truoc day bi bo
  // vi da co so mo phong ghi de. Nay mo phong tat mac dinh nen phai doc that.
  Dist4 = getValue(raw, ',', 10).toFloat(); 

  RainPercent = getValue(raw, ',', 11).toInt(); AirTemp = getValue(raw, ',', 12).toFloat(); AirHum = getValue(raw, ',', 13).toFloat();
  
  if (systemMode == 1 && lastLoraRxTime == 0) updateOLED("CHE DO AUTO", "Dang hoat dong");
  lastLoraRxTime = millis(); xSemaphoreGive(systemMutex);
  
  if (currentPage == 1) updateDashboard(); 
  telemetryPending = true;
}

void processLoRaSync(const String& incomingData) {
  if (!incomingData.startsWith("<B:SYNC:") || !incomingData.endsWith(">")) return;
  String content = incomingData.substring(8, incomingData.length() - 1);
  int equalIdx = content.indexOf('='); if (equalIdx < 0) return;
  String devName = content.substring(0, equalIdx); 
  int stateVal = content.substring(equalIdx + 1).toInt(); bool isOn = (stateVal == 1);
  
  xSemaphoreTake(systemMutex, portMAX_DELAY);
  if (devName == "MODE") { 
    systemMode = stateVal; 
    if (systemMode == 0) { 
        for (int i = 0; i < 5; i++) pumpState[i] = false; 
        for (int i = 0; i < 4; i++) valveState[i] = false; 
    } 
  } 
  else if (devName.startsWith("BOM")) { 
    int num = devName.substring(3).toInt(); 
    if (num >= 1 && num <= 5) pumpState[num - 1] = isOn; 
  } 
  else if (devName.startsWith("VAN")) { 
    int num = devName.substring(3).toInt(); 
    if (num >= 1 && num <= 4) valveState[num - 1] = isOn; 
  }
  xSemaphoreGive(systemMutex); 
  
  if (currentPage == 3) updateNextionControlStates(); 
  if (currentPage == 1) updateDashboard(); 
  deviceStatePending = true;
}

String espLoraRxBuffer = "";

// KHÔI PHỤC BẮT LỖI ESTOP LORA GỐC
void handleLoraIncoming() {
  while (loraSerial.available()) {
    char c = loraSerial.read();
    
    if (c == '\n' || c == '\r') {
      espLoraRxBuffer.trim();
      if (espLoraRxBuffer.length() > 0) {
        
        // Bắt lệnh ESTOP chủ động từ STM32
        if (espLoraRxBuffer == "<B:ESTOP>") {
            enqueueEmergencyStop();
            updateOLED4("BAO DONG LORA", "STM32 bao Mua To!", "", "Da ngat he thong!");
        }

        processLoRaData(espLoraRxBuffer); 
        processLoRaSync(espLoraRxBuffer); 

        if (isWaitingAck) {
          char nodeTag = currentCommand.charAt(1); 
          int colonIdx = currentCommand.indexOf(':');
          String cmdBody = currentCommand.substring(colonIdx + 1, currentCommand.length() - 1); 
          bool isAck = false;

          if (nodeTag == 'A') {
            if (cmdBody == "GET_DATA" && espLoraRxBuffer.startsWith("<A:DATA:")) isAck = true;
          } else if (nodeTag == 'B') {
            if (espLoraRxBuffer.startsWith("<B:ACK_" + cmdBody + ">")) isAck = true;
          }

          if (isAck) {
              applyConfirmedState(cmdBody);
              isWaitingAck = false; 
              retryCount = 0;
              if (webCommandId >= 0) setWebAckResult(webCommandId, true);
              currentCommand = ""; 
              if(cmdBody != "GET_DATA") updateOLED("TRANG THAI: OK", "Da phan hoi");
              lastSendTime = millis() - INTER_CMD_DELAY; 
          }
        }
      }
      espLoraRxBuffer = "";
    } else {
      espLoraRxBuffer += c;
      if (espLoraRxBuffer.length() > 300) espLoraRxBuffer = "";
    }
  }
}

void updateNextionSettingsPage() {
  // Dang dung o trang cai dat thi bo tien to "page5." — Nextion bao loi khi ghi
  // co tien to vao chinh trang dang hien.
  String p = (currentPage == 2) ? "" : "page5.";

  sendText(p + "t0.txt", String(phMin, 1)); sendText(p + "t1.txt", String(phMax, 1));
  sendText(p + "t2.txt", String(ecMin, 1)); sendText(p + "t3.txt", String(ecMax, 1));
  sendText(p + "t4.txt", String(tempMin, 1)); sendText(p + "t5.txt", String(tempMax, 1));
  sendText(p + "t6.txt", String(humMin, 1)); sendText(p + "t7.txt", String(humMax, 1));
  sendText(p + "t8.txt", String(timeBom)); sendText(p + "t9.txt", String(timeNghi));
}

void processNextionCommand(String rawCmd) {
  String cleanCmd = ""; for (int i = 0; i < rawCmd.length(); i++) { char c = rawCmd.charAt(i); if (c >= 32 && c <= 126) cleanCmd += c; }
  if (cleanCmd.length() == 0) return; String cmdUpper = cleanCmd; cmdUpper.toUpperCase();

  if (cmdUpper.indexOf("MENU_READY") >= 0 || cmdUpper.indexOf("ABOUT_READY") >= 0) { currentPage = 0; updateWiFiIcon(); return; }
  if (cmdUpper.indexOf("DASHBOARD_READY") >= 0) { currentPage = 1; updateWiFiIcon(); updateDashboard(); return; }
  if (cmdUpper.indexOf("SETTINGS_READY") >= 0) {
    updateWiFiIcon();
    // Chi nap lai so cu khi VUA CHUYEN TOI trang cai dat. Neu dang o san trang
    // do (currentPage == 2) thi su kien nay den tu viec go ban phim — nap lai
    // luc nay se xoa mat con so nguoi dung vua nhap.
    if (currentPage != 2) updateNextionSettingsPage();
    currentPage = 2;
    return;
  }
  if (cmdUpper.indexOf("CONTROL_READY") >= 0) { currentPage = 3; updateWiFiIcon(); updateNextionControlStates(); return; }

  if (cmdUpper.startsWith("CHECK_PASS=")) {
    String entered = cmdUpper.substring(11); entered.trim(); systemPassword.trim();
    if (entered == systemPassword) sendNextionCmd("page page1"); else { sendNextionCmd("va0.val=1"); sendNextionCmd("t0.pw=0"); sendNextionCmd("t0.pco=63488"); sendNextionCmd("t0.txt=\"X\""); } return;
  }
  if (cmdUpper.startsWith("CHGPASS=")) {
    String data = cmdUpper.substring(8); int f = data.indexOf(','), s = data.lastIndexOf(',');
    if (f >= 0 && s > f) {
      String op = data.substring(0, f), np1 = data.substring(f + 1, s), np2 = data.substring(s + 1); op.trim(); np1.trim(); np2.trim();
      if (op != systemPassword) { sendNextionCmd("t0.pw=0"); sendNextionCmd("t0.pco=63488"); sendNextionCmd("t0.txt=\"X\""); }
      else if (np1 != np2) { sendNextionCmd("t2.pw=0"); sendNextionCmd("t2.pco=63488"); sendNextionCmd("t2.txt=\"X\""); }
      else { systemPassword = np1; preferences.begin("system_data", false); preferences.putString("password", systemPassword); preferences.end(); sendNextionCmd("page page0"); }
    } return;
  }
  if (cmdUpper == "CMD=MODE_AUTO") { safelySwitchMode(1); return; }
  if (cmdUpper == "CMD=MODE_MANUAL") { safelySwitchMode(0); return; }
  if (cmdUpper.indexOf("ESTOP") >= 0 || cmdUpper.indexOf("DUNGKHANCAP") >= 0) { enqueueEmergencyStop(); return; }

  if (cmdUpper == "CMD=GET_DATA" || cmdUpper == "B2" || cmdUpper == "CMD=B2") {
    if (!isCommandInQueue("<A:GET_DATA>")) {
      enqueueCommand("<A:GET_DATA>");
      updateOLED("LORA TX:", "Yeu cau Data"); 
    }
    return;
  }

  if (cmdUpper.startsWith("BOM")) {
    int eqRaw = rawCmd.indexOf('='); 
    if (eqRaw >= 0 && eqRaw + 1 < rawCmd.length()) {
      int eqClean = cmdUpper.indexOf('='); int num = cmdUpper.substring(3, eqClean).toInt();
      char valChar = rawCmd.charAt(eqRaw + 1); bool isOn = (valChar == '1' || valChar == 0x01 || valChar == 'O' || valChar == 'o'); 
      if (systemMode == 0) {
        enqueueCommand(isOn ? "<B:ON" + String(num) + ">" : "<B:OFF" + String(num) + ">");
      } else if (currentPage == 3) updateNextionControlStates(); 
    } return;
  }
  if (cmdUpper.startsWith("VAN")) {
    int eqRaw = rawCmd.indexOf('='); 
    if (eqRaw >= 0 && eqRaw + 1 < rawCmd.length()) {
      int eqClean = cmdUpper.indexOf('='); int num = cmdUpper.substring(3, eqClean).toInt();
      char valChar = rawCmd.charAt(eqRaw + 1); bool isOn = (valChar == '1' || valChar == 0x01 || valChar == 'O' || valChar == 'o'); 
      if (systemMode == 0) {
        int relay = num + 5; 
        enqueueCommand(isOn ? "<B:ON" + String(relay) + ">" : "<B:OFF" + String(relay) + ">");
      } else if (currentPage == 3) updateNextionControlStates();
    } return;
  }

  int saveIdx = cmdUpper.indexOf("SAVE=");
  String dataToSave = "";
  
  if (saveIdx >= 0) {
    dataToSave = cleanCmd.substring(saveIdx + 5);
  } else if (cleanCmd.indexOf(",") > 0 && cleanCmd.length() > 10) {
    dataToSave = cleanCmd;
  }

  if (dataToSave != "") {
    dataToSave.replace(" ", ""); 

    float nPhMin = getValue(dataToSave, ',', 0).toFloat();
    float nPhMax = getValue(dataToSave, ',', 1).toFloat();
    float nEcMin = getValue(dataToSave, ',', 2).toFloat();
    float nEcMax = getValue(dataToSave, ',', 3).toFloat();
    float nTempMin = getValue(dataToSave, ',', 4).toFloat();
    float nTempMax = getValue(dataToSave, ',', 5).toFloat();
    float nHumMin = getValue(dataToSave, ',', 6).toFloat();
    float nHumMax = getValue(dataToSave, ',', 7).toFloat();
    int nTimeBom = getValue(dataToSave, ',', 8).toInt();
    int nTimeNghi = getValue(dataToSave, ',', 9).toInt();

    if (nTimeBom <= 0) nTimeBom = 1; 
    if (nTimeNghi < 0) nTimeNghi = 0;
    
    phMin = nPhMin; phMax = nPhMax; ecMin = nEcMin; ecMax = nEcMax; 
    tempMin = nTempMin; tempMax = nTempMax; humMin = nHumMin; humMax = nHumMax; 
    timeBom = nTimeBom; timeNghi = nTimeNghi;
    
    preferences.begin("system_data", false);
    preferences.putFloat("phMin", phMin); preferences.putFloat("phMax", phMax); 
    preferences.putFloat("ecMin", ecMin); preferences.putFloat("ecMax", ecMax);
    preferences.putFloat("tempMin", tempMin); preferences.putFloat("tempMax", tempMax); 
    preferences.putFloat("humMin", humMin); preferences.putFloat("humMax", humMax);
    preferences.putInt("timeBom", timeBom); preferences.putInt("timeNghi", timeNghi); 
    preferences.end();
    
    enqueueCommand("<SET_DATA=" + dataToSave + ">"); 
    settingsPending = true; 
    if (currentPage == 2) updateNextionSettingsPage(); 
    return;
  }

  if (cmdUpper.indexOf("CMD=REBOOT") >= 0) { updateOLED("SYSTEM", "Rebooting..."); sendNextionCmd("page page0"); delay(1000); ESP.restart(); }
  
  if (cmdUpper.indexOf("CMD=RESTORE") >= 0) {
    phMin = 5.5; phMax = 6.5; 
    ecMin = 1.5; ecMax = 3.0;     
    tempMin = 22.0; tempMax = 35.0; 
    humMin = 100.0; humMax = 100.0; 
    timeBom = 1; timeNghi = 0;     

    preferences.begin("system_data", false);
    preferences.putFloat("phMin", phMin); preferences.putFloat("phMax", phMax); 
    preferences.putFloat("ecMin", ecMin); preferences.putFloat("ecMax", ecMax);
    preferences.putFloat("tempMin", tempMin); preferences.putFloat("tempMax", tempMax); 
    preferences.putFloat("humMin", humMin); preferences.putFloat("humMax", humMax);
    preferences.putInt("timeBom", timeBom); preferences.putInt("timeNghi", timeNghi); 
    preferences.end();
    
    if (currentPage == 2) updateNextionSettingsPage(); 
    enqueueCommand("<SET_DATA=5.5,6.5,1.5,3.0,22.0,35.0,100.0,100.0,1,0>"); 
    settingsPending = true; 
    return;
  }
}

void handleNextionIncoming() {
  while (nextion.available()) { String rawCmd = nextion.readStringUntil('\n'); if (rawCmd.length() > 0) processNextionCommand(rawCmd); }
}

void setup() {
  Serial.begin(115200); systemMutex = xSemaphoreCreateMutex(); queueMutex = xSemaphoreCreateMutex();
  Wire.begin(I2C_SDA, I2C_SCL); if (display.begin(SSD1306_SWITCHCAPVCC, SCREEN_ADDRESS)) { display.setRotation(2); updateOLED("MASTER BOOT", "Khoi tao..."); }
  pinMode(LORA_M0, OUTPUT); pinMode(LORA_M1, OUTPUT); pinMode(LORA_AUX, INPUT);
  digitalWrite(LORA_M0, LOW); digitalWrite(LORA_M1, LOW);
  unsigned long auxStart = millis(); while (digitalRead(LORA_AUX) == LOW && (millis() - auxStart < 3000UL)) delay(10);
  loraSerial.setRxBufferSize(512); loraSerial.begin(9600, SERIAL_8N1, LORA_RX_PIN, LORA_TX_PIN); loraSerial.setTimeout(20); 
  while (loraSerial.available()) loraSerial.read();
  nextion.begin(115200, SERIAL_8N1, NEXTION_RX, NEXTION_TX); nextion.setTimeout(20); delay(500); while (nextion.available()) nextion.read();
  
  preferences.begin("system_data", false); 
  systemPassword = preferences.getString("password", "123456"); 
  
  phMin = 5.5; phMax = 6.5; 
  ecMin = 1.5; ecMax = 3.0; 
  tempMin = 22.0; tempMax = 35.0; 
  humMin = 100.0; humMax = 100.0; 
  timeBom = 1; timeNghi = 0; 

  preferences.putFloat("phMin", phMin); preferences.putFloat("phMax", phMax); 
  preferences.putFloat("ecMin", ecMin); preferences.putFloat("ecMax", ecMax); 
  preferences.putFloat("tempMin", tempMin); preferences.putFloat("tempMax", tempMax); 
  preferences.putFloat("humMin", humMin); preferences.putFloat("humMax", humMax); 
  preferences.putInt("timeBom", timeBom); preferences.putInt("timeNghi", timeNghi); 
  preferences.end();

  WiFi.mode(WIFI_STA); WiFi.begin(ssid, password); updateOLED("WIFI", "Connecting...");
  int wifiAttempts = 0; while (WiFi.status() != WL_CONNECTED && wifiAttempts < 20) { delay(500); wifiAttempts++; }
  if (WiFi.status() == WL_CONNECTED) { configTime(gmtOffset_sec, daylightOffset_sec, ntpServer); updateOLED("MASTER READY", "WiFi Connected"); } else updateOLED("MASTER READY", "WiFi Offline");
  sendNextionCmd("page page0"); xTaskCreatePinnedToCore(webTask, "WebTask", 12288, NULL, 1, &webTaskHandle, 0);
}

void loop() {
  handleLoraIncoming(); 
  processLoRaQueue();
  handleAutoMixingLogic(); 
  handleAutoIrrigationLogic(); 
  handleNextionIncoming();

  // ==========================================================
  // MÔ PHỎNG MỰC NƯỚC: THỰC TẾ 1 PHÚT ĐỘC LẬP
  // ==========================================================
  static unsigned long lastSimTime = 0;
  
  if (SIMULATE_TANK_LEVEL && millis() - lastSimTime >= 1000) { 
    xSemaphoreTake(systemMutex, portMAX_DELAY);
    
    // Bơm 3 chạy (cấp nước) -> Khoảng cách giảm 1.0cm/s (Từ 80 -> 20 mất đúng 60 giây)
    if (mixState == MIX_PUMPING_WATER) { 
        simDist4 -= 1.0;  
        if (simDist4 < 10.0) simDist4 = 10.0; 
    }
    // Bơm 4 chạy (tưới) -> Khoảng cách tăng 1.0cm/s (nước rút đi)
    else if (autoState == AUTO_IRRIGATING) {
        simDist4 += 1.0; 
        if (simDist4 > 85.0) simDist4 = 85.0; 
    }
    
    // Ghi đè tuyệt đối giá trị mô phỏng
    Dist4 = simDist4; 
    xSemaphoreGive(systemMutex);
    
    lastSimTime = millis();
    if (currentPage == 1) updateDashboard(); 
  }
  // ==========================================================

  if (systemMode == 1) { 
    if (millis() - lastSensorPollTime >= AUTO_POLL_INTERVAL) { 
        lastSensorPollTime = millis(); 
        if (!isCommandInQueue("<A:GET_DATA>")) {
            enqueueCommand("<A:GET_DATA>"); 
        }
    } 
  }
  
  if (millis() - lastUpdate >= 1000UL) { lastUpdate = millis(); updateClock(); }
  bool needWiFiUpdate = false; 
  xSemaphoreTake(systemMutex, portMAX_DELAY); 
  if (wifiUIUpdatePending) { needWiFiUpdate = true; wifiUIUpdatePending = false; } 
  xSemaphoreGive(systemMutex);
  
  if (needWiFiUpdate) { 
      updateWiFiIcon(); 
      if (systemMode != 1) updateOLED("MASTER READY", WiFi.status() == WL_CONNECTED ? "WiFi Connected" : "WiFi Offline"); 
  }
  delay(5);
}
