minhnhatluongg/lora_project/(commit log)

2026-07-31 Map STM32 node's full sensor set into backend + dashboard
    The STM32 firmware reads 11 values but the backend only stored 5, so NPK and
    all four ultrasonic sensors had nowhere to go. EC was also off by 1000x: the
    RS485 probe reports raw µS/cm (~1200) while the backend assumed mS/cm (~1.8).
    Backend:
    - telemetry gains n/p/k and dist1..dist4; ALTER TABLE migration keeps existing
    databases working, and a one-shot v2 migration rescales stored EC readings,
    the ecMax threshold and any EC-based automation rule into µS/cm.
    - POST /api/telemetry accepts the firmware's own field names (Nitrogen, Dist1,
    pH_Value, ...) alongside the short ones, maps the firmware's -1 "no echo"
    marker to NULL, a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
    [esp32_master_example.ino, main.cpp]
2026-07-31 Add field-deployment guide for running with real hardware
    Step-by-step runbook from "PC only has the code" to "dashboard shows live
    readings", with an acceptance check at the end of each step so a failure is
    caught where it happens rather than three steps later.
    Covers wiring (including the pins the uplink added), flashing, running the
    backend and frontend on a LAN, tank calibration, and a troubleshooting table
    keyed to the sensor_status values the firmware reports.
    Three hardware gotchas the firmware implies but does not state are called out:
    the sketch drives no RS485 DE/RE pin, so an auto-direction transceiver is
    required; the buttons use INPUT rather than INPUT_PULLUP, so external pull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
2026-07-31 Fix reliability bugs that only surface with real hardware
    Six problems found by working through what actually happens in the field. The
    first was reproduced in the existing database, not hypothesised: van1 and van2
    were sitting at status 'sent' from an earlier session.
    1. Devices could die permanently. /commands/pending marks a command 'sent', and
    runAutomation skips any device with a non-acked command. So a master that
    rebooted between fetching and acking left that device excluded from
    automation forever, with nothing to clear it. Commands now retry when an ack
    doesn't arrive, give up as 'failed' after COMMAND_MAX_ATTEMPTS, and expire
    after COMMAND_TTL_SECONDS. A one-off mig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
    [esp32_master_example.ino, main.cpp]
2026-08-07 Rebuild the dashboard to match the team's control-panel design
    Reworked the UI from the panel mockup: light theme across the whole app,
    bilingual VN/EN labels, line icons instead of emoji, and the two headline card
    rows exactly as drawn. The charts, table and alerts stay below the fold, so
    nothing built earlier is lost.
    The mockup carried a domain fact the code didn't have: the four ultrasonic
    sensors are not generic tanks but a fertigation rig — Bồn Kali, Bồn Đạm, Bồn
    Nước and Trộn. Defaults renamed accordingly, each with its own glyph, and the
    tank list is now the compact form the panel uses rather than vertical gauges.
    Colour: the panel's hues (blue / green / purple / or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
2026-08-07 Build the five-page control panel from the team's HMI design
    The reference design (front_require/) is a five-screen touch panel, and it asks
    for more than the app had: air temperature, air humidity and a rain sensor; five
    pumps instead of one; an emergency stop; MIN/MAX threshold pairs; irrigation
    timing; and Menu, About and Change Password screens that did not exist.
    Pages — Menu is now the landing screen, with Dashboard, Control, Settings, About
    and Change Password behind it. Every page shares one chrome (brand, home button,
    live clock, link lamp, decorated title, back pill). No sidebar: the panel
    navigates through Menu and the home button, so Layout/Sidebar are gone. Each
    page owns its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
2026-08-10 Wire the ESP32 master into the backend API so the source runs as downloaded
    The three sketches show the real topology, which is not the one the earlier
    bridge assumed: STM32 talks to the ESP32 over LoRa E32 (not UART), the ESP32
    drives a Nextion HMI and a second LoRa link to an Arduino Nano holding ten
    relays, and it already carries its own irrigation and fertiliser-mixing state
    machines. Its WiFi was only ever used to fetch the time — nothing reached the
    web dashboard.
    Added that missing link inside the ESP32 sketch, leaving the Nextion, LoRa and
    AUTO logic untouched: every <DATA:...> packet is forwarded to /api/telemetry;
    /api/commands/pending is polled and translated into <ONn>/<OFFn>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
    [esp32_master.ino, main.cpp, nano_relay.ino]
2026-08-10 Rewrite the field guide around the real three-station topology
    The shared Google Doc rewrites HUONG-DAN-CHAY-THAT.md for the architecture the
    sketches actually implement — three LoRa stations rather than a direct UART hop —
    so this takes its structure and its additions (the Nano cabinet station, the
    14-field <DATA:> packet, flashing the Nano before the ESP32, commissioning AUTO
    through the relay station).
    Five figures in that draft disagreed with the code, and the code won:
    - The STM32 LoRa pins were labelled and wired backwards. `HardwareSerial
    loraSerial(PA3, PA2)` makes PA3 the RX and PA2 the TX, so PA3 goes to the
    module's TXD and PA2 to its RXD. The draft had PA2 as "RX2 → T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
2026-08-10 Correct the tank mapping to the wiring the hardware team confirmed
    The order is dist1=Đạm, dist2=Kali, dist3=Nước, dist4=Trộn. The first two were
    the wrong way round everywhere: defaults, labels, colours, glyphs and every
    document. This is the answer to the three-way conflict flagged earlier, so the
    "verify this before running" warnings are replaced by the settled table.
    Tank colour and glyph now follow the substance rather than the sensor number —
    Đạm green with a leaf, Kali purple with a flask — so the tank list reads the same
    way as the NPK chart above it.
    Existing databases keep their names in app_config, so a schema_version 5
    migration swaps the stored pair. It only fir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
    [main.cpp]
2026-08-14 Come up in MANUAL so AUTO is always a deliberate choice
    A fresh install seeded system_status with mode = 'AUTO', which armed the
    backend automation engine before anyone asked for it. Nothing fired yet only
    because no automation rules ship enabled -- adding a single rule would have
    started a real pump with no operator action.
    Both firmware boards already default to manual (esp32_master systemMode = -1,
    nano_relay isAutoMode = false), so the backend was the one layer out of step.
    Migration v6 flips existing databases over unconditionally: MANUAL is the
    fail-safe direction, and a stored row cannot tell 'never touched' apart from
    'deliberately set to AUTO'. Operators who want AUTO press it on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
2026-08-14 Add a setup-gotchas note for running the project on another machine
    Written from the errors a teammate actually hit on a fresh clone, so it leads
    with the two that look alarming but are not code faults:
    - VSCode underlining #include <HardwareSerial.h> in the .ino file. The C/C++
    extension cannot see the Arduino ESP32 core and says so itself in the same
    message ("Squiggles are disabled for this translation unit"). Sketches must
    be opened in Arduino IDE to verify and upload.
    - Vite reporting ECONNREFUSED ::1:4000, which just means only the frontend was
    started. Backend and frontend are two processes in two terminals.
    Also covers the WiFi/IP lines that must change per machine, why One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
2026-08-14 Make running the panel a deliberate choice, and stagger the switch-on
    CONTROL used to open with MANUAL preselected, so the switches were live the
    moment the screen rendered. mode gains a third value, 'NONE': nothing is
    selected, every output is locked, and the operator has to pick. That mirrors
    esp32_master.ino, which has always started at systemMode = -1 ("chưa chọn").
    Picking AUTO now energises the whole panel first. Three things had to be true
    for that to work against the real boards:
    - Valves are ordered before pumps. A pump started against a shut valve is
    dead-heading into a closed line; the firmware's own AUTO state machine
    sequences AUTO_OPEN_VALVE -> wait -> AUTO_START_PUMP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
2026-08-14 Document the CONTROL flow, and correct two things we had wrong
    Written to answer "does setting a threshold open a valve?" -- it does not, and
    the reason is that SETTINGS holds two unrelated things that both read as
    "ngưỡng": alert thresholds, which only ever raise alerts, and automation rules,
    which drive relays and ship disabled. Something only happens when the rule is
    enabled AND the system is in AUTO AND a fresh reading arrives.
    Two claims that were being repeated, including in our own firmware/README.md,
    turn out not to match the code:
    - "Both brains fight over the relays and the pump chatters." They cannot. With
    the ESP32 in AUTO it refuses every web command outright, so the back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
2026-08-15 Accept the threshold sync the master has started sending
    The new firmware posts the ten values an operator entered on the Nextion to
    /api/config/thresholds, with a comment in the sketch asking us to check the
    endpoint exists. It did not -- configRouter only had GET / and PUT /, so every
    sync was answering 404 and the web SETTINGS screen kept showing a stale copy of
    what the panel was actually running on.
    Device-authenticated, because the master has no user account. The body is flat
    and uses the firmware's own names, three of which differ from ours, so the
    mapping is explicit rather than a spread: humMin/humMax become humidityMin and
    humidityMax, timeBom and timeNghi become irrigation runMin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
2026-08-15 Adopt the hardware team's new firmware drop as received
    Committed verbatim, before any of our fixes, so the next commit's diff is
    exactly the list of things that had to be re-applied. The team does not use
    git and hands over whole files, so this will happen again; new_firmware/ keeps
    the pristine copy to diff against next time.
    What they changed:
    - The STM32 is largely rewritten. Air temperature, humidity and rain are real
    now -- DHT22 on PA0 and an ADC rain board on PA1 with a moving-average filter,
    replacing the hardcoded 32.5 / 70.0 / 15 stub. Readings moved into a struct
    with per-group validity flags and error counters. The <DATA:> packet is
    unchanged: still fourteen fields in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
    [main.cpp, nano22222.ino]
2026-08-15 Re-apply what the drop lost, and fix the EC units that were hiding behind it
    The team edited their own copy rather than the one carrying our bridge, so five
    things came back. Four were regressions; the fifth had been there all along and
    only became reachable once the others were fixed.
    EC units. ecMin/ecMax defaulted to 1.0 and 2.0 -- mS/cm -- and were compared
    against EC_Value, which the RS485 probe reports in µS/cm at around 1500. So
    "EC_Value > ecMax" was permanently true: the mixer sat in add-water forever,
    never set isMixingReady, and automatic irrigation could therefore never start at
    all. The agronomic intent is kept exactly, only the unit changes: 1000 and 2000
    µS/cm. ecToMicro()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
    [esp32_master.ino]
2026-08-15 Tell the panel builders what the EC unit change means for the HMI
    The .HMI file lives with the hardware team, so the firmware change has a loose
    end only they can tie off. Written for them.
    The obvious half is the label: two fields on the SETTINGS page now read µS/cm,
    not mS/cm. The half that actually breaks things is txt_maxl -- the displayed
    value grows from three characters to six, and a field trimmed down to four or
    five silently truncates 1000.0, which the ESP32 then reads back as a different
    threshold. That check comes first in the document.
    Also warns that t2 and t3 exist on both the dashboard and the settings page --
    live pH and EC on one, EC limits on the other -- and that the fi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
2026-08-18 Adopt the hardware team's rewritten firmware drop as received
    Committed verbatim before our fixes, so the next commit's diff is exactly what
    had to change. The team does not use git and hands over whole files; the drop
    also switched the STM32 from a PlatformIO main.cpp to a plain .ino, so
    platformio.ini now points src_dir at the sketch folder and both toolchains build
    the same single source.
    The rewrite is a real step forward and mostly addresses what we reported:
    - Manual and automatic commands are now two separate families. <ONn> is only
    accepted while the relay board is in MANUAL, <AUTOONn> only while it is in
    AUTO, and a refusal comes back as a genuine NACK instead of a fake ACK. T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
    [nano_relay.ino, stm32_sensor_node.ino]
2026-08-18 Fix what the drop still got wrong, and let the panel report itself
    Three of these came out of compiling the sketches for the first time -- the
    project had never been built, only read.
    Nano was at 89% RAM with 223 bytes left for the stack, while the code allocates
    Strings on almost every LoRa message. Heap growing into the stack is a random
    reset, and it would happen mid-command. Wrapping 22 Serial literals in F() moves
    them to flash: 52% used, 981 bytes free, warning gone.
    STM32 would not link at all: the sketch declares its own Serial1, which the
    STM32duino core already defines, so the linker reported a duplicate symbol. The
    variable is renamed rs485Port -- same UART, same PA10/PA9 pins,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
    [esp32_master.ino, nano_relay.ino, stm32_sensor_node.ino]
2026-08-18 Show what the field engine is doing, instead of nine grey switches
    In AUTO the CONTROL screen said "TỰ ĐỘNG" and locked every switch, which is
    honest but useless: the operator's first question is always why it has not
    started watering, and the screen could not answer. The two state machines now
    report their current step, and the page draws them as a progress strip -- mixing
    above, irrigation below, with the gate between them saying in words whether the
    solution has passed EC and released the irrigation lock.
    The strip is deliberately compact: it sits between the mode panel and the valve
    panel on a 1024x600 HMI, and an earlier version with a label under every step
    pushed the valve switc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
2026-08-18 Update the guides to what the rig actually does, and add the progress report
    The guides had been telling readers to fix things that were already fixed. They
    still said Dist3/Dist4 were the wrong way round and that the air and rain values
    were hardcoded stubs; both were corrected in the hardware team's rewrite, so
    anyone following the documents would have re-broken working code. They also
    described the AUTO button as switching the whole panel on, and mode sync as
    one-way, neither of which is true any more.
    firmware/README.md is deleted rather than corrected. Almost all of it had gone
    stale, and what remained duplicated HUONG-DAN-CONTROL.md; the parts worth
    keeping (which toolchain per board,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
2026-08-19 Adopt the addressed-protocol firmware drop as received
    Committed verbatim before our fixes, as with the previous two drops, so the next
    commit's diff is exactly what had to change.
    The big change is addressing. Both LoRa peers now share one air with an explicit
    prefix: <A:...> is the STM32 sensor node, <B:...> is the Nano relay board, and
    each ignores anything not addressed to it. That is a cleaner answer to the
    collision problem than the poll-only scheme it replaces.
    It also carries the new Nextion LoRa button (b2 on the dashboard page): pressing
    it queues <A:GET_DATA>, the STM32 answers with <A:DATA:...> immediately, so an
    operator can force a fresh reading instead of waiting for the nex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
    [essp32.ino, main.cpp, nano111.ino, stm32_sensor_node.ino]
2026-08-19 Fix three things the new drop still gets wrong
    Small, targeted; the drop is otherwise a clear improvement and is left alone.
    STM32 would not link. The sketch declares its own Serial1, which the STM32duino
    core already defines, so the linker reported a duplicate symbol. Renamed to
    rs485Port -- same UART, same PA10/PA9 pins, every use goes through the
    RS485_Serial macro so nothing else changes.
    EC thresholds still defaulted to 1.0 and 2.0 -- mS/cm -- while EC_Value arrives
    from the probe in µS/cm at around 1500, so "EC_Value > ecMax" was permanently
    true and the mixer could never finish. Same fix as before: 1000 and 2000 µS/cm,
    with ecToMicro() normalising at each entry point.
    The Nano ha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
    [esp32_master.ino, nano_relay.ino, stm32_sensor_node.ino]
2026-08-19 Revert the firmware to the drop exactly as delivered
    The three sketches are now byte-identical to new_firmware/ again. Reverted at the
    team's request: the ESP32 is theirs to write and to verify on the bench, and
    patches landing from this side make that harder, not easier.
    What this gives back, recorded so nobody rediscovers it the hard way:
    - STM32 does not link. It declares its own Serial1, which the STM32duino core
    already defines. Whoever builds it either renames the variable or configures
    the core with U(S)ART support set to "no generic Serial".
    - EC thresholds default to 1.0 and 2.0 while the probe reports µS/cm around
    1500, so the mixer never finishes and automatic irrigation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
    [esp32_master.ino, nano_relay.ino, stm32_sensor_node.ino]
2026-08-19 Add a fetch-now button to the web dashboard
    The STM32 only transmits when asked, so an operator watching the dashboard waits
    out the poll interval to see a fresh reading. The Nextion screen already has a
    button for this -- b2 on its dashboard page, which queues <A:GET_DATA> and gets
    an immediate answer. This puts the same control on the web, placed next to the
    title so it sits where the Nextion one does.
    Three small pieces:
    - ESP32 accepts device_id "system" with action "GET_DATA" from the command
    queue and turns it into the same <A:GET_DATA> the Nextion button sends, reusing
    the existing isCommandInQueue guard so repeated presses cost one transaction.
    Placed beside the mode and esto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
2026-08-20 Read the state-machine codes the new master actually sends
    The team's latest ESP32 adds POST /api/status/report -- the two-way mode sync
    that had been missing -- and starts reporting which step each state machine is
    on. It sends those as enum ordinals, not names:
    doc["autoState"] = (int)autoState;
    doc["mixState"] = (int)mixState;
    reportFromMaster() only accepted strings, so both numbers were dropped without a
    word: mode and mixReady landed, the steps silently did not. Now integers are
    mapped through name tables that mirror the enums in esp32_master.ino, strings
    still work for anyone testing with curl, and an ordinal outside the table is
    ignored rather than guessed at.
    Those table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
    [esp2tesst.ino]
2026-08-20 Serve the dashboard and the API from one origin
    The site now hosts the built frontend as well as proxying the API, so
    deploy/web.config carries both jobs. Same origin means the browser calls /api
    relatively: no CORS entry, no VITE_PROXY_TARGET, and no rebuild when the domain
    changes -- which matters because the current domain is borrowed from another
    project.
    Rule order is the whole trick. The SPA fallback matches everything, so it has to
    come second or it swallows /api and answers index.html instead of reaching Node.
    The two negate conditions on it are what keep real files and folders being
    served, so assets\ still works.
    Two things fixed from the version running on the server:
    - errorMo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
2026-08-20 Use the real logo on the login screen too
    The login card was still drawing the school's name as two styled lines of text
    while the rest of the app had switched to the actual image, so the first screen
    anyone sees carried a different mark from every screen after it.
    Same file, same treatment as the header: height is fixed and width follows the
    1260x428 ratio, so the card does not jump a line when the image finishes
    loading.
    Checked by rendering it: the image reports its natural 1260x428, no console
    errors, and the card is unchanged apart from the mark.
2026-08-20 Put the login card over a field video
    The brief was an agency landing page -- navbar, hero copy, mobile menu, a studio
    called Atelier. None of that belongs on the way into an irrigation dashboard, so
    what carried over is the part that fits: a full-bleed farm video behind the sign
    in card.
    Built with the CSS already in this project rather than the Tailwind the brief
    assumed. The app has seven dependencies and no build-time CSS pipeline; adding
    Tailwind, PostCSS, autoprefixer and an icon library to a deployed app for one
    screen costs more than it returns, and the same layout is a dozen plain rules.
    The video is ~10 MB from CloudFront, so it cannot be a precondition for logging
    in -- the pane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
2026-08-20 Let the field video show through the login card
    The card was nearly opaque white and a full-screen black wash sat over the video
    to guarantee contrast, which meant the footage -- the one thing meant to carry
    the screen -- arrived dimmed and half hidden.
    Contrast is now the card's job rather than the whole viewport's. The full wash is
    gone; only a soft vignette remains so the frame edges do not bleed. The card is
    real glass at 55% dark tint with a 22px blur, so the machine and sky read through
    it while text stays legible.
    55% is not an aesthetic pick. Below it, white text starts failing the moment a
    bright cloud passes behind the card, and the video is in constant motion so that
    is not a hy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
2026-08-20 Thin the login card and open up the wordmark
    Card tint drops from 0.55 to 0.46 so more of the field shows through -- the
    ground and the machine's wheels now read under the lower half of the card.
    Blur goes up to 30px to pay for it. That is not decoration: blur mixes a bright
    cloud with the blue around it before any text sits on top, so the worst-case
    patch behind the card is never as bright as the cloud itself. Without that, 0.46
    would lose the small labels every time weather crosses behind the card, and the
    footage is in constant motion.
    The small text also picks up a faint shadow for the same reason. On a card this
    thin, 13px type is the first thing to go.
    SMART FARM gets 4px of letter-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
2026-08-20 Fold the form tables into cards on phones, pin the log table's time column
    The two SETTINGS tables and the USERS table are forms, not readouts. Sideways
    scrolling breaks a form outright: by the time the "Khi can" box is on screen
    its column heading has scrolled off, so you are typing into an unlabelled
    field. At phone width each row now folds into a card with the column name
    beside its own control. Measured: 328px wide inside a 328px viewport, no
    horizontal scroll left on either page.
    DASHBOARD's history table is the opposite case — eight columns of readings
    people may actually want, so dropping columns would lose data. It keeps
    scrolling, but usefully: the time column is pinned, so the K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
2026-08-21 Add task assignment, and swap the ABOUT tile for it
    Three roles existed only to gate buttons. They are now also a chain of
    command: you can assign to anyone ranked below you, so admin assigns to
    technicians and viewers, technicians assign to viewers, viewers assign to
    nobody. One rank comparison in auth.js rather than a list of allowed pairs,
    so a fourth role later is one line.
    The rule is enforced in the route, not just hidden in the UI. Hiding the
    button only stops ordinary users; the POST is checked against the target's
    real role before the row is written.
    Backend, schema v10:
    - tasks(title, body, assignee, assigner, priority, status, due_at,
    seen_at, done_at, result_note)
    - PRA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
2026-08-21 Make the history chart span its window, and keep 7 days not 90
    /api/telemetry/history read `ORDER BY created_at ASC LIMIT 500`, which is the
    500 OLDEST rows in the window, not 500 spread across it. Once the ESP32 is on
    a real probe it posts every 3 seconds, so 500 rows is 25 minutes: the "24 hour"
    chart would have drawn 25 minutes of yesterday and stopped, with the newest
    reading never reaching it. Measured on 28,800 seeded rows at the real 3-second
    cadence: last point 1,415 minutes stale.
    Now the window is cut into `limit` time buckets and one real reading is taken
    per bucket -- MAX(id), the last in the bucket, not an average. Averaging would
    invent values that were never measured, and eve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
2026-08-21 Rebuild the USERS screen to match the rest of the panel
    USERS was the one screen still wearing a bare `.panel` with an <h3>, while
    every other page uses the card with a glyph and an uppercase title over a
    blue rule. It now wears the same chrome, and it reports the socket to the
    shell's link lamp -- alone among the pages it passed nothing, so the lamp
    sat grey on a live connection.
    prompt() and confirm() are gone. That is not a coat of paint: prompt() shows
    a new password in clear text, offers no second box to check it against, and
    enforces no length, so one mistyped character locks somebody out with nobody
    the wiser. The replacement dialog takes the password twice, refuses anything
    under si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
2026-08-24 Stop the panel claiming a mode no hardware has confirmed
    Reported from the field: someone opened CONTROL and found TỰ ĐỘNG already
    selected, and read that as "the system is running in AUTO". Checked the live
    server rather than guessing:
    mode: "AUTO", masterOnline: false, masterSeenAt: null, engineSeenAt: null
    So nothing had defaulted to AUTO -- a person had picked it, and the mode
    persists, which is correct: mode is system state, not a per-visit choice. The
    real fault is what the screen then asserted. masterSeenAt is null, meaning the
    ESP32 has never once contacted that server, so the mode command is still
    sitting in the queue unread. The panel drew a confidently-selected AUTO above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
2026-08-30 Fix the live push that never connected, and take the team's newest ESP32 sketch
    The reported symptom: press ON, the command reaches the ESP32 and the relay
    closes, but the icon on the web stays OFF until F5. Reproduced it the long way
    round and the cause is not in the control path at all -- the socket never
    connected on the deployed site.
    socket.js pinned `transports: ['websocket', 'polling']`, which reads as
    "prefer websocket, fall back to polling". socket.io v4 does not do that: it
    holds the first transport and retries it. Measured against the real domain
    with the app's exact options -- five websocket errors over 14 seconds and no
    connection at all, never once trying polling. With the opt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
    [esp32iotlast.ino]
2026-08-30 Merge the new ESP32 sketch instead of adopting it wholesale
    Taking esp32iotlast.ino as-is silently dropped six working behaviours. Kept
    everything new, put back everything lost.
    Kept from the team's version (verified present, 11 of 11): the https base now
    that it connects, LoRa ack timeout 800 -> 2000ms, sequential irrigation across
    all four valves, the water-level simulation, mixing driven by a real tank
    reading instead of a 5-second timer, the stirring pump with a 20s settle, the
    abort when the tank runs dry mid-irrigation, <B:ESTOP> arriving from the STM32,
    and removal of the 5s LoRa guard that froze both state machines.
    Put back (9 edits):
    - the whole /api/status/report path -- flag,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
2026-09-02 Read the tank for real, fix EC units, and support HTTPS properly
    Three things the user asked for after the merge.
    Tank level was simulated, not measured. The STM32 does send Dist4 -- position
    10 of its payload, confirmed in prepareLoraSensorData -- but the ESP32 stopped
    parsing it and overwrote it once a second from a counter, so the mixing tank
    reading on screen was a number nobody measured. Parsing restored, and the
    simulation is now behind SIMULATE_TANK_LEVEL, default false: the demo mode
    still exists as one line to flip, rather than being deleted or being the
    silent default.
    EC read 0.00 mS/cm on the dashboard. The unit contract breaks exactly at the
    ESP32/web boundary and it breaks in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
    [esp32_master.ino]
2026-09-02 Stop attempting a WebSocket upgrade the server cannot complete
    Every connection logged a red "WebSocket connection failed" in the console.
    The app was fine underneath -- the stack trace shows onHandshake -> _probe, so
    the socket had already connected and this was only the upgrade attempt failing,
    after which it stays on polling and keeps delivering. But a permanent red error
    on screen is not something to carry into a demo, and retrying a doomed upgrade
    on every connect buys nothing.
    The server cannot tunnel it. ARR returns a correct 101 Switching Protocols and
    then, on the same connection, sends Transfer-Encoding: chunked followed by the
    empty terminating chunk "0\r\n\r\n" -- it is completi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
2026-09-02 Measure a signal we can actually read, instead of an empty column
    The "Chất lượng sóng LoRa" panel has been drawing an empty chart since it
    shipped. I built it on the `lora_rssi` column and told the user the data was
    already there — it never was. The E32 module talks to the ESP32 over plain
    UART and exposes no command to read RSSI, so the firmware had nothing to send
    and the column has been NULL from the first row.
    WiFi.RSSI() needs no hardware change and returns a real RF measurement, just
    of a different hop: ESP32 <-> router rather than ESP32 <-> sensor node. That
    is a smaller claim than the panel used to make, and it is a true one.
    Stored in a new `wifi_rssi` column rather than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
2026-09-02 Actually send the emergency stop and the settings to the panel
    Two controls were writing to the database and stopping there.
    SETTINGS saved thresholds server-side and queued nothing. The ESP32 sits behind
    NAT, so anything meant for it has to wait in the command queue until it asks —
    and nothing was ever put there. The firmware has had a handler for these
    settings all along; it had simply never been given one to handle. The web
    showed the new numbers while the panel kept irrigating on the old ones, with
    nothing on either screen to say the two disagreed.
    EMERGENCY STOP was worse, because it looked like it worked. It queued OFF for
    all nine actuators and then, last, mode=MANUAL. But the fir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
2026-09-02 Tell the web when the panel changes a threshold
    BUG-01 from the team's bug log. The report blamed the React page for not
    listening; the truth is there was nothing to listen to. setConfig() wrote to
    SQLite and returned, and EVENTS carried no entry for configuration at all —
    neither side of the wire had this event.
    So an operator could change a threshold at the Nextion in the cabinet and the
    web page would keep drawing the old numbers indefinitely. Nothing on screen
    suggested a refresh would help, which is the worst part: a stale reading that
    looks live.
    The event rings empty, like TASKS and for the same reason — the socket is
    unauthenticated, so anything pushed through it reaches every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
    [Bug_Log_Smart_Farm.xlsx]
2026-09-02 Stop making the operator wait three seconds for a relay
    BUG-04, the last of the four. The team's log filed it as By Design and it was
    half right — the ESP32 is behind NAT, so it has to ask rather than be told, and
    asking on a cycle means the cycle IS the latency. Measured: 1826 ms average,
    2785 ms worst, from button press to the device holding the command.
    The obvious fix is the wrong one. Shortening WEB_POLL_INTERVAL multiplies the
    cost of asking, and asking is expensive here: the firmware sets setReuse(false),
    so every poll opens a fresh TLS connection, and the network task is a single
    sequential loop that also pushes telemetry, device state and status reports.
    Polling three times as of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
    [Bug_Log_Smart_Farm.xlsx]
2026-09-03 Export the dashboard to Excel, and stop claiming the slave is online
    Two things, both from what the screenshot showed.
    The "Kênh realtime: ĐANG KẾT NỐI" row is not about the field at all — it is the
    socket between this browser and the server, which is up because the server is
    up. Correct value, misleading placement: sitting under ESP32 Master and Node
    cảm biến it reads as a third device. Moved below a divider and renamed to name
    both ends.
    Worse in the same panel, "Node cảm biến: ONLINE" beside "Dữ liệu gần nhất: 5
    giờ trước". slave_online was read straight out of the row with no freshness
    check at all, so when the master stopped reporting the flag simply froze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
2026-09-03 Write the report your friend has to defend tomorrow
    A 23-page Word document, in Vietnamese, covering the system and how to drive
    the web interface. Roughly half of it is Part IV — the operator's guide —
    because that is what was asked for and because a report nobody can follow is
    not a report.
    Every figure in it was read out of this repository rather than recalled:
    thresholds and defaults from config.js, the role table from auth.js, the page
    list from the router, the API groups from index.js, the poll and telemetry
    intervals from the firmware. The latency and request-rate numbers are the ones
    measured in this session, not estimates.
    The parts most likely to earn marks are the ones that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
